rz7mong/mochi-rzmong/README.md

# 🍡 Mochi rzmong




Desk buddy **ESP32-C3 Super Mini** + LCD **ST7789 1.3" 240×240** (modul GMT130, PCB 27.78×39.22 mm, 7 pin tanpa CS): wajah **GIF**, reaksi sentuh, **SFX WAV**. Proyek open-source independen — **terinspirasi** Dasai Mochi, **bukan** produk resmi / clone berlisensi.

**Firmware: 0.5.6** · **MIT © rzmong** · English: [README.en.md](README.en.md)

Satu sumber situs/installer: **https://rz7mong.github.io/mochi-rzmong/**  
(`rz7mong.github.io` tanpa path adalah arsip — jangan flash dari sana.)

Di perangkat: **GIF + WAV 16-bit saja** (tidak ada pemutar MP4, tidak ada decoder MP3).

## 🚀 Mulai cepat

1. Chrome / Edge → [Instalasi firmware 0.5.6](https://rz7mong.github.io/mochi-rzmong/) (tahan BOOT, colok USB-C).
2. Wi-Fi AP default: **`rzmong mochi` / `rzmong123`** — sandi lab; **ganti** `MOCHI_AP_PASS` di firmware lalu flash ulang sebelum dipakai di tempat umum.
3. Pengaturan (disarankan): **`http://192.168.4.1/`** di AP perangkat.
4. Pack tema: [mochi-themes.zip](https://github.com/rz7mong/mochi-rzmong/releases/download/assets-v1/mochi-themes.zip) (Release [`assets-v1`](https://github.com/rz7mong/mochi-rzmong/releases/tag/assets-v1)) → ekstrak ke root SD FAT32 (`gif/` + `sfx/`). Tanpa SD pun, 30 GIF+WAV bawaan di flash langsung jalan.

## 🕐 Jam HP

LCD ini bukan layar sentuh. Jam HP dipilih dari HP.

1. Sambungkan Wi-Fi `rzmong mochi`, sandi `rzmong123`.
2. Buka `http://192.168.4.1/`.
3. Centang **Chronos BLE** dan **Jam HP**, lalu simpan.
4. Di aplikasi Chronos, sambungkan perangkat bernama `rzmong`.

Layar menampilkan GIF wajah default (senyum + kedip; `wajah/default.gif` di SD, atau versi bawaan di flash) dengan tanggal, jam, dan baterai HP di atasnya. Hilangkan centang Jam HP untuk kembali ke GIF. Notifikasi, panggilan, dan navigasi tetap menutup jam sementara.

Ketukan menu hanya dipakai jika ada kawat sentuh di GPIO1. Tanpa kawat itu, abaikan ketukan.

## 🔗 Tautan

| | |
| --- | --- |
| ⚡ Instalasi | https://rz7mong.github.io/mochi-rzmong/ |
| 🔧 Merakit + pin | [docs/hardware.html](https://rz7mong.github.io/mochi-rzmong/hardware.html) |
| 🧩 Demo rakit interaktif | [kabel lepas](https://rz7mong.github.io/mochi-rzmong/pemasangan-kabel.html) · [PCB carrier](https://rz7mong.github.io/mochi-rzmong/pemasangan.html) |
| 📖 Panduan pakai | [docs/panduan.html](https://rz7mong.github.io/mochi-rzmong/panduan.html) |
| 🎨 Studio (convert) | [docs/studio.html](https://rz7mong.github.io/mochi-rzmong/studio.html) |
| ⚙️ Pengaturan online | [docs/pengaturan.html](https://rz7mong.github.io/mochi-rzmong/pengaturan.html) |
| 🤝 Handoff | [HANDOFF.md](HANDOFF.md) · [halaman](https://rz7mong.github.io/mochi-rzmong/handoff.html) |
| 🧊 Case STL | [case/](case/) |
| 🟩 PCB carrier (opsional) | [pcb/](pcb/README.md) |
| 📌 Konstanta | [PRODUCT.md](PRODUCT.md) |

## 🔌 Wiring firmware 0.5.6

Sumber pin: `firmware/include/MochiRzmong.h` + `User_Setup_ST7789.h`.

Diagram resmi: [docs/wiring-0.5.1.jpg](docs/wiring-0.5.1.jpg) · halaman [hardware](https://rz7mong.github.io/mochi-rzmong/hardware.html).

```
ESP32-C3 Super Mini
  Touch OUT → GPIO1
  SD  SCK=4  MOSI=6  MISO=3  CS=5     (SPI berbagi SCK/MOSI dengan TFT)
  TFT SCLK=4 MOSI=6  CS=7*   DC=10  RST=0   BLK→3V3 (bukan 5V)
  I2S BCLK=21  LRC=20  DIN=8          (MAX98357; speaker ke OUT+/OUT− amp)
  GPIO2 dan GPIO9 — jangan disolder (strapping C3)
```

\* LCD GMT130 7 pin (GND VCC SCL SDA RES DC BLK) **tidak punya kaki CS** — GPIO7 dibiarkan kosong (CS di firmware tetap GPIO7, tidak mengganggu). Kabel disolder langsung ke pad LCD (tanpa pin header) karena tatakan baru hanya menyisakan ±2 mm di belakang baris pin.

**Pemasangan LCD:** di [tatakan GMT130](case/README.md) LCD dipasang **pin di bawah**. Mulai firmware 0.5.4 rotasi default = **2** (180°) supaya gambar tegak. Kalau masih pakai tatakan lama / pin di atas: menu LCD → **Rotasi layar** 2× (atau build dengan `-DMOCHI_DEFAULT_ROTATION=0`).

| Net | Apa yang disambung |
| --- | --- |
| GABUNG 3V3 | TFT VCC + BLK, SD VCC, TTP223 VCC |
| GABUNG GND | semua modul |
| GABUNG SCK GPIO4 | TFT SCL + SD SCK |
| GABUNG MOSI GPIO6 | TFT SDA + SD MOSI |
| GABUNG VIN | ESP VIN + MAX98357 VIN **setelah saklar** |

CS tidak berbagi: TFT **GPIO7** ≠ SD **GPIO5** ≠ sentuh **GPIO1** ≠ DIN **GPIO8**.

**Bukan “boot-safe”.** GPIO8 (DIN) adalah pin strapping C3. GPIO20/21 adalah UART0 — log boot bisa bocor ke I2S (“plok” di speaker). Pakai **USB CDC**, jangan andalkan UART0.

**Daya:** LiPo → TP4056 **berproteksi** (DW01/8205A) → saklar → GABUNG VIN. LCD/SD/sentuh makan **3V3 ESP**, bukan 5V.

**Amp:** pasang kapasitor **≈470 µF** (elektrolit, ≥10 V) antara **VIN MAX98357 dan GND**, sedekat mungkin ke modul. Tanpa ini amp mudah “ceklek” / brown-out saat bass.

**SD:** modul harus **native 3.3V** (bukan reader 5V / level-shifter 5V). Kartu FAT32. MISO = GPIO3, bukan GPIO2.

**Varian PCB carrier (opsional):** semua modul di atas bisa dipasang di [PCB etsa tangan 38.5 × 36 mm](pcb/README.md) (satu sisi, THT) dengan case/tatakan `_pcb`. Pin sama dengan tabel di atas. Part khusus varian ini: speaker **15 × 11 × 3.5 mm**, kapasitor **470 µF 10 V Ø6.3 × 11** tegak, modul **micro SD 3.3 V kecil ±18.5 × 20 mm**, LiPo **501640**. Rakitan kabel lepas tetap didukung.

Blueprint + STL: [hardware.html](https://rz7mong.github.io/mochi-rzmong/hardware.html).

## 🛠️ Troubleshooting singkat

| Gejala | Cek |
| --- | --- |
| Port tidak muncul di Chrome | Pakai **Chrome/Edge** (bukan Safari / in-app). Tahan **BOOT**, colok USB-C, lepas BOOT. Coba kabel data lain. |
| Wi-Fi tidak ketemu | Flash **0.5.6**. SSID **`rzmong mochi`**, bukan `Mochi-rzmong`. |
| Sandi ditolak | Default **`rzmong123`**, bukan `rzmong24`. |
| Layar putih/hitam | RST=**0**, DC=10, SCLK=4, MOSI=6, BLK=3V3 (CS=7 hanya jika modul punya kaki CS) |
| Gambar terbalik | Firmware 0.5.6 default rotasi 2 untuk LCD pin di bawah. Menu LCD → **Rotasi layar** 2× untuk membalik 180°. |
| SD gagal | FAT32, modul **3.3V native**, MISO=**3**, CS=5 — bukan GPIO2 |
| Amp berisik / mati saat bass | Kapasitor ≈470 µF di VIN amp |
| Bunyi plok saat boot | UART0 di 20/21 + strapping GPIO8. Jangan tarik DIN ke GND. |
| Upload dari Pages gagal | Mixed content. Upload lewat `http://192.168.4.1/` |

## 🎞️ GIF + WAV bawaan (0.5.6)

Tanpa kartu SD, firmware memutar **30 slot GIF+WAV di flash** (1,04 MB di partisi app; WAV 8 kHz 16-bit mono):

- **wajah/default** — wajah putih senyum + kedip (dari video), dipakai juga untuk Jam HP dan diselang di antara klip lain.
- **Wajah/musik warna (reaksi sentuh)**: raspberry (tickle), squint (kedip), love_hearts_kiss (cinta), angry_2 (marah), smirk (ketawa), sleepy (ngantuk), yawn_tired (nguap), rainbow (pelangi), pong (pong).
- **Mobil (14)**: revs (ngebut), headlights, accel, gtr_rain, road_rage, rotation, speed_2, speed_3, tsurikawa, turbo, car, lb, lb_intro, lb_star.
- **Gundam (6)**: hadouken_miss, hadouken_hit (reaksi hadouken), blade, mecha_doc, titan, equip. Gundam besar (kokpit, pilot, helm…) hanya dari SD.

File SD dengan tema+stem sama tetap didahulukan (reaksi sentuh selalu cek SD dulu). Daftar & urutan: `firmware/assets/meta.json`, file: `firmware/assets/builtin/`.

## 🎬 Media

Studio butuh internet (FFmpeg.wasm). Setelah file jadi, sambung AP Mochi lalu unggah di captive (same-origin).

Pasangan: `/gif/<tema>/<stem>.gif` + `/sfx/<tema>/<stem>.wav`

## 🏗️ Build

```bash
cd firmware
python tools/embed_assets.py
pio run -e esp32-c3-super-mini
```

## 📄 Lisensi

**MIT © rzmong** — lihat [LICENSE](LICENSE) dan [THIRD_PARTY_NOTICES.md](THIRD_PARTY_NOTICES.md) (ChronosESP32 / fbiego).
