rz7mong/mochi-rzmong/case/stickers_yaemiko/README.md

# MOCHI rzmong · Sakura Kitsune: lembar stiker terinspirasi Yae Miko (`case_luar_lcd_23_40mm.stl`)

Set decal bertema kuil rubah untuk case [`case_luar_lcd_23_40mm.stl`](../case_luar_lcd_23_40mm.stl) (63.9 × 93.5 × 53.4 mm). Motifnya semua orisinal: siluet kitsune (topeng dan rubah duduk berekor tiga), bunga dan kelopak sakura, jimat ofuda, omamori, tali shimenawa dengan kertas shide, lonceng suzu, gerbang torii, dan petir untuk aksen Electro.

Palet warna: pink sakura `#F2A7C3`, putih, merah kuil `#C8202F`, ungu Electro `#8E4FD6`, emas `#D4A64A`, navy gelap `#1C1E3D`.

> Desain buatan penggemar yang **terinspirasi karakter Yae Miko. Bukan produk resmi.** Tidak ada art resmi, logo, nama game, maupun merek dagang Genshin Impact / HoYoverse di dalamnya. Kanji yang dipakai hanya kata umum (桜 sakura, 狐 rubah, 雷 petir, 御守 jimat, 白狐, 桜花, 雷光, 餅), dan teks latinnya cuma "MOCHI rzmong", "SAKURA KITSUNE", dan "KITSUNE". Lencana petir dalam belah ketupat juga bentuk orisinal, bukan ikon elemen dari game.

Ukuran, posisi, dan penomoran potongan sama dengan lembar LBWK ([`../stickers/`](../stickers/)) dan lembar gaya Gundam ([`../stickers_gundam/`](../stickers_gundam/)).

## File

| File | Isinya |
|---|---|
| `sticker_sheet_A4_white_vinyl.pdf` / `.svg` | **File cetak utama.** A4, skala 1:1, gambar + garis potong magenta `#FF00FF` 0.1 mm (layer tersendiri di SVG) |
| `sticker_sheet_A4_white_vinyl_PRINT_ONLY_no_cutlines.pdf` | Halaman yang sama tanpa garis potong, untuk mesin print-and-cut (Cricut / Silhouette / Brother) |
| `sticker_sheet_A4_CUT_ONLY.svg` / `.pdf` | Hanya jalur potong, posisinya pas dengan halaman A4 yang sama |
| `sticker_sheet_A4_clear_vinyl.pdf` / `.svg` | Versi vinyl bening (bagian putih dihilangkan). Pakai hanya di case putih atau yang dicat putih |
| `sticker_sheet_A4_white_vinyl_preview.png` | Pratinjau lembar utama 200 dpi |
| `placement_guide.png` | Enam tampilan dengan posisi bernomor dan keterangan tiap stiker |
| `mockup_stickers_applied.png`, `mockup_closeups.png` | Render case dengan stiker terpasang |

## Cetak

- Cetak di **100 % / "Actual size"**, jangan pernah "Fit to page". Pastikan batang 50 mm benar-benar 50 mm dan kotaknya 10 × 10 mm.
- **Bahan:** vinyl printable putih glossy + laminasi bening glossy, atau kertas decal waterslide putih yang ditutup clear coat.
- Printer rumahan tidak bisa mencetak warna putih. Di lembar putih, tulisan MOCHI, topeng rubah, bunga putih, dan kertas shide berupa vinyl polos; di vinyl bening bagian itu jadi transparan. Pink, ungu, dan emas di vinyl bening juga agak tembus pandang.
- **Warna emas dicetak sebagai oker datar**, bukan metalik. Kalau mau emas mengilap sungguhan, perlu foil atau printer tinta metalik.
- Potongan solid punya bleed 0.5 mm; decal yang berdiri sendiri punya margin putih 0.3 mm.
- Semua teks sudah di-outline. Teks terkecil (tinggi huruf kapital sekitar 0.75–1.0 mm: teks melingkar di emblem, "KITSUNE", baris kecil di sayap dan skirt) butuh printer **≥1200 dpi** dalam mode best/photo. Tanda utama (MOCHI 4.4 mm, segel 狐, blok 雷, kanji ofuda) tetap tajam.
- Sekitar 75 mm bagian bawah lembar sengaja dikosongkan. Potong dan pakai lagi vinylnya.

## Pemasangan

- **Depan** = sisi layar. **L** = sisi kiri mobil (+X), **R** = sisi kanan mobil (−X), dilihat dari belakang. Pasangan cermin (3, 4, 5, 6, 8) ada versi R/L; rubah, petir, dan bunga di ujung jejak kelopak selalu menghadap ke depan.
- Urutan yang disarankan: IPA → depan (18, 19, 20) → skirt 6R/6L, lalu 1–5 di tiap sisi → belakang (10, 11, 9, 13, 12) → sayap (7, 8R/8L) → ventilasi 14 → semprotan sakura 15 → strip kubah 16a–d (atau 17) → tambahan 21 sesuai selera → clear coat tipis opsional (coba dulu di stiker cadangan).
- Coba pas-kan potongan besar (7, 18, 3, 13) dengan kertas alasnya masih terpasang sebelum dikelupas.
- Strip kubah 16a–d dipotong per segmen karena kubahnya melengkung. Tempel di garis tengah, ujung ketemu ujung, mulai dari tengah ke arah luar; sedikit panas hair dryer membantu. Kalau berkerut, pakai strip tunggal ALT (17B pink, 17C ungu). Untuk waterslide, pakai decal softener di bagian kubah.
- **Potongan yang rumit:** kertas shide di 2/13, garis rubah dan torii (21c, 21f), dan margin kelopak kecil 21a punya bagian yang tipis. Potong pelan-pelan dengan **pisau yang tajam/baru**, atau sederhanakan jalur potongnya di SVG kalau mesin potongnya kesulitan.

## Persiapan permukaan

- **Resin:** cuci sampai bersih dan lakukan **post-cure penuh** (resin yang masih lengket membuat stiker tidak menempel), amplas tipis bekas support atau beri primer/cat kalau mau, lalu **lap dengan IPA** tepat sebelum menempel.
- **FDM (PLA/PETG):** amplas tipis garis layer-nya atau beri primer, lalu lap dengan IPA.

Keterangan lengkap stiker beserta ukuran dan posisi pastinya: lihat `placement_guide.png`.
