rz7mong/mochi-rzmong/case/stickers/README.md

# Mochi rzmong: lembar stiker gaya LBWK

Livery buatan penggemar yang orisinal (putih / hitam / merah) untuk case Mochi. **Terinspirasi gaya LBWK (Liberty Walk) / F40. Bukan produk resmi.** Tidak ada logo resmi Liberty Walk, Ferrari, atau Dasai di dalamnya, dan semua nama sponsor (KUMO FUEL, PIXEL GRIP, RZMONG WORKS, DESK GT) hanya karangan.

Ukuran diukur pada case [`case_luar_lcd_23_40mm.stl`](../case_luar_lcd_23_40mm.stl) (63.9 × 93.5 × 53.4 mm).

## File

| File | Isinya |
|---|---|
| `sticker_sheet_A4_white_vinyl.pdf` / `.svg` | **File cetak utama.** A4, skala 1:1, gambar plus garis potong magenta 0.1 mm (layer SVG "CUT") |
| `sticker_sheet_A4_white_vinyl_PRINT_ONLY_no_cutlines.pdf` | Halaman yang sama tanpa garis potong, untuk mesin print-and-cut (Cricut / Silhouette / Brother) |
| `sticker_sheet_A4_CUT_ONLY.svg` / `.pdf` | Hanya jalur potong, posisinya pas dengan halaman A4 yang sama |
| `sticker_sheet_A4_clear_vinyl.pdf` / `.svg` | Versi vinyl bening. Bagian putih dihilangkan, jadi pakai hanya di case berwarna putih |
| `sticker_sheet_A4_white_vinyl_preview.png` | Pratinjau lembar stiker 200 dpi |
| `placement_guide.png` | Posisi penempelan bernomor dan keterangan tiap stiker |
| `mockup_stickers_applied.png`, `mockup_closeups.png` | Render case dengan stiker terpasang |

## Cetak

- Cetak di **100 % / "Actual size"**, jangan "Fit to page". Pastikan batang 50 mm benar-benar 50 mm dan kotaknya 10 × 10 mm.
- **Bahan:** vinyl printable putih glossy dengan laminasi bening glossy, atau kertas decal waterslide putih yang ditutup clear coat. Kalau pakai printer inkjet, gunakan vinyl khusus inkjet dan biarkan hasil cetak kering sekitar 1 jam sebelum dilaminasi.
- Printer rumahan tidak bisa mencetak warna putih. Di vinyl bening, area "putih" akan jadi transparan dan memperlihatkan warna case.

## Pemasangan

- **Depan** = sisi layar. **L** = sisi kiri mobil (+X), **R** = sisi kanan mobil (−X), dilihat dari belakang.
- Urutan yang disarankan: splitter dan grille (17, 18, 19), lalu skirt dan samping (5, 1–4), belakang (9, 10, 8, 12, 11), sayap (6, 7), ventilasi (13), dan strip kubah paling akhir (14/15 atau 16).
- Strip kubah dibagi menjadi beberapa segmen karena kubahnya melengkung ke dua arah. Tempel tiap segmen di garis tengah, mulai dari bagian tengahnya, lalu pertemukan ujung-ujungnya. Hangatkan vinyl dengan hair dryer dan tekan ke arah luar. Kalau stripnya berkerut, pakai strip ALT yang lebih tipis (16).
- Tekan penutup ventilasi (13) ke alur kisi-kisi dengan kuku.
- Kalau mau, akhiri dengan clear coat tipis. Coba dulu di stiker cadangan.

## Persiapan permukaan

- **FDM (PLA/PETG):** amplas tipis garis layer-nya, atau beri primer dan cat, lalu lap dengan IPA. Vinyl kurang menempel di garis layer yang kasar.
- **Resin:** cuci dan lakukan post-cure penuh terlebih dahulu, karena resin yang belum matang membuat lem tidak menempel. Setelah itu amplas tipis atau beri primer, lalu lap dengan IPA tepat sebelum menempel.

Keterangan lengkap stiker beserta ukuran dan posisi pastinya: lihat `placement_guide.png`.
