rz7mong/mochi-rzmong/case/stickers_gundam/README.md

# MOCHI rzmong RZ-78: lembar stiker gaya Gunpla/mecha (`case_luar_lcd_23_40mm.stl`)

Set decal untuk case [`case_luar_lcd_23_40mm.stl`](../case_luar_lcd_23_40mm.stl) (63.9 × 93.5 × 53.4 mm). Desain orisinal dengan skema warna ala RX-78: putih, biru `#1F4FA8`, merah `#D61F26`, kuning `#F5C400`, hampir hitam `#1A1A1C`.

> Terinspirasi decal model kit Gunpla / mecha. **Bukan produk resmi.** Tidak ada nama atau logo Gundam, Bandai, atau Sunrise di dalamnya. Semua kode (RZ-78, MOCHI-01, R.Z.M.F., "MOCHI CORPS", LOT 0026) hanya karangan.

## File
| file | isinya |
|---|---|
| `sticker_sheet_A4_white_vinyl.pdf` / `.svg` | File cetak **utama**: A4, skala 1:1, gambar + garis potong magenta `#FF00FF` 0.1 mm (layer tersendiri di SVG). |
| `sticker_sheet_A4_white_vinyl_PRINT_ONLY_no_cutlines.pdf` | Halaman yang sama tanpa garis potong, untuk mesin print-and-cut. |
| `sticker_sheet_A4_CUT_ONLY.svg` / `.pdf` | Hanya jalur potong, posisinya pas dengan halaman A4 yang sama. |
| `sticker_sheet_A4_clear_vinyl.pdf` / `.svg` | Versi vinyl bening (bagian putih dihilangkan). Hanya untuk case putih atau yang dicat putih. |
| `sticker_sheet_A4_white_vinyl_preview.png` | Pratinjau lembar utama 200 dpi. |
| `placement_guide.png` | Enam tampilan dengan posisi bernomor dan keterangan tiap stiker. |
| `mockup_stickers_applied.png`, `mockup_closeups.png` | Render case dengan decal terpasang. |

## Cetak
* Cetak di **100 % / "Actual size"**, jangan pernah "Fit to page". Cek batang 50 mm dan kotak 10 × 10 mm.
* **Bahan:** vinyl printable putih glossy + laminasi bening glossy, atau kertas decal waterslide putih yang ditutup clear coat (paling mirip decal "model kit").
* Printer rumahan tidak bisa mencetak warna putih: teks putih akan berupa vinyl polos (lembar putih) atau tembus pandang (lembar bening).
* Potongan solid punya bleed 0.5 mm; decal yang berdiri sendiri punya margin putih 0.3 mm.
* Semua teks sudah di-outline. Teks mikro terkecil (tinggi huruf kapital 0.72–0.95 mm) butuh printer **≥1200 dpi** dalam mode best/photo; teks ini hanya hiasan. Tanda utama (1.9–4.6 mm) tetap terbaca.
* Sekitar 90 mm bagian bawah lembar sengaja dikosongkan — potong dan pakai lagi.

## Tips pemasangan
* **Persiapan cetakan resin:** cuci sampai bersih dan lakukan **post-cure penuh** (resin yang masih lengket membuat stiker tidak menempel), amplas tipis bekas support, beri primer/cat kalau mau, lalu **lap dengan IPA** sebelum menempel.
* Coba pas-kan potongan besar (7, 18, 3) dengan kertas alasnya masih terpasang sebelum dikelupas.
* Potongan kubah yang melengkung (14, 15, 16a–d) — tempel dari tengah ke arah luar; sedikit panas akan membantu. Gunakan decal softener untuk waterslide. Kalau tri-stripe 5.5 mm berkerut, pakai strip tunggal ALT (17B/17C).
* Urutan yang disarankan: IPA → depan (18, 19, 20) → samping (6, 1–5) → belakang (10, 11, 9, 13, 12) → sayap (7, 8) → ventilasi 14 → V-fin 15 → strip kubah 16/17 → tambahan 21 → clear coat tipis opsional (coba dulu).
* Depan = sisi layar; pasangan cermin (3–6, 8) R/L; chevron dan segitiga selalu menghadap ke depan. Lihat `placement_guide.png` untuk posisi pastinya.
