rz7mong/mochi-rzmong/PRODUCT.md

# Product constants (single source of truth)

| Key | Value |
| --- | --- |
| **Version** | `0.5.6` |
| **Brand** | `rzmong` |
| **AP SSID** | `rzmong mochi` |
| **AP password** | `rzmong123` (change in firmware; not exposed in API JSON) |
| **On-device settings** | `http://192.168.4.1/` (captive UI — recommended) |
| **Studio** | Convert online, then upload via captive form on AP |
| **GIF size limit** | max **~600000** bytes upload buffer |
| **Chronos BLE name** | `rzmong` |
| **Jam HP** | phone time over wajah/default.gif (SD, else built-in smile+blink face), phone battery % |
| **Built-ins** | 30 GIF+WAV slots in flash (`firmware/assets/builtin/`, list in `firmware/assets/meta.json`), WAV 8 kHz 16-bit mono; 11 tap reactions |
| **Theme pack** | Release `assets-v1` → [mochi-themes.zip](https://github.com/rz7mong/mochi-rzmong/releases/download/assets-v1/mochi-themes.zip) (86 GIF + 87 WAV) |
| **Media** | GIF 240×240 + WAV 16-bit mono ~22 kHz |
| **Hardware** | ESP32-C3 Super Mini + ST7789 1.3" 240×240 GMT130 (PCB 27.78×39.22 mm, 7-pin, no CS) |
| **LCD mount** | `case/tatakan_GMT130_fit.stl`, pins-down → default rotation `2` (`MOCHI_DEFAULT_ROTATION`) |

```c
#define MOCHI_VERSION "0.5.6"
#define MOCHI_AP_NAME "rzmong mochi"
#define MOCHI_AP_PASS "rzmong123"
```

**Erase on install:** wipes NVS (theme, volume, Chronos). SD is separate.

**GIF+SFX pair:** `/gif/<tema>/<stem>.gif` + `/sfx/<tema>/<stem>.wav`

**Touch (device):** notif 1-tap · call hold 0.6s · nav 2-tap hide · play 1-tap react / 2-tap menu
