rz7mong/mochi-rzmong/docs/HANDOFF.md

# Handoff — Mochi rzmong v0.5.6

Salinan web: [handoff.html](handoff.html) · sumber repo: [../HANDOFF.md](https://github.com/rz7mong/mochi-rzmong/blob/main/HANDOFF.md)

| Key | Value |
| --- | --- |
| Version | **0.5.6** |
| AP | `rzmong mochi` / `rzmong123` (lab; ganti di firmware) |
| Settings | `http://192.168.4.1/` |
| Settings (Pages) | [pengaturan.html](pengaturan.html) |
| Install | https://rz7mong.github.io/mochi-rzmong/ |
| Theme pack | [assets-v1](https://github.com/rz7mong/mochi-rzmong/releases/tag/assets-v1) · [mochi-themes.zip](https://github.com/rz7mong/mochi-rzmong/releases/download/assets-v1/mochi-themes.zip) (86 GIF + 87 WAV) |
| Built-ins | 30 GIF+WAV di flash (`firmware/assets/builtin/`, `meta.json`); wajah/default baru (senyum + kedip) |
| Hardware | ESP32-C3 Super Mini + ST7789 1.3" 240×240 GMT130 (27.78×39.22 mm, 7 pin tanpa CS, pin di bawah) |
| Media | GIF + WAV 16-bit (bukan MP4/MP3) |
| License | MIT © rzmong |

Jam HP: dipilih dari HP di http://192.168.4.1/ (centang Chronos BLE dan Jam HP). LCD tidak sentuh. GPIO1 hanya jika ada kawat sentuh.
