rz7mong/mochi-rzmong/case/stickers_yaemiko/mockup_closeups.png

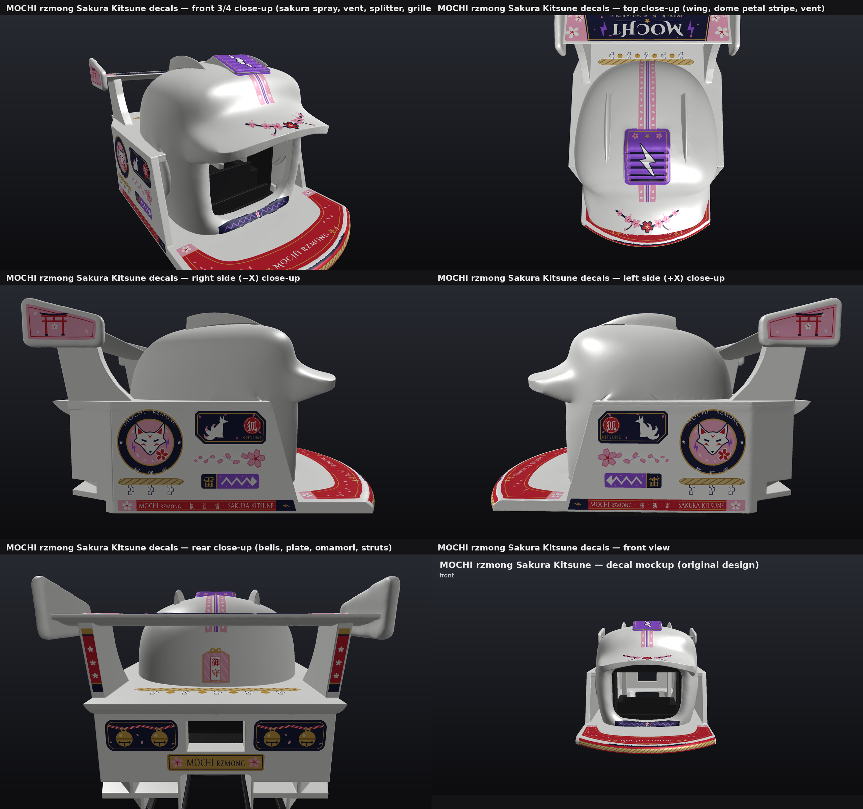
case/stickers_yaemiko/mockup_closeups.png
