rz7mong/mochi-rzmong/case/stickers_yaemiko/mockup_stickers_applied.png

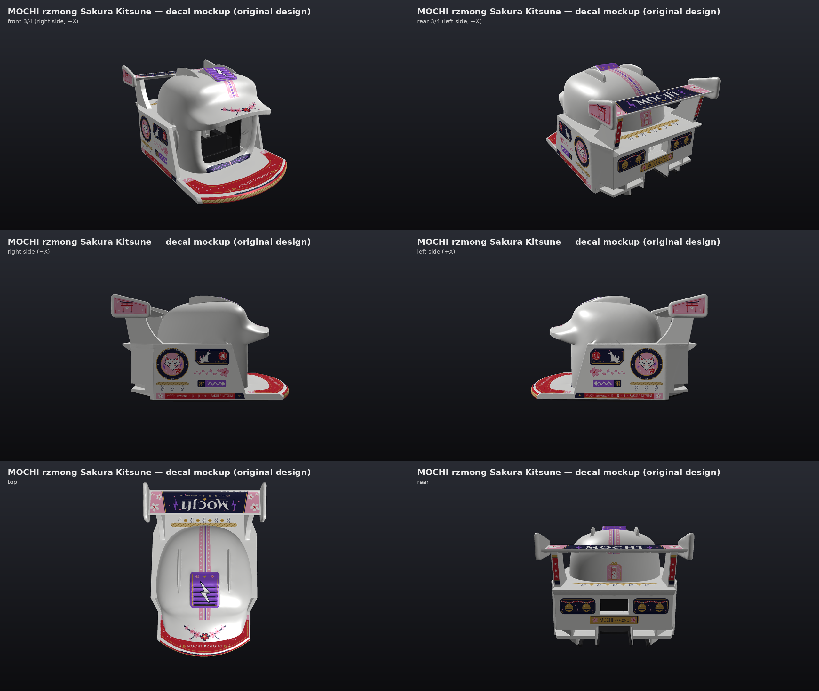
case/stickers_yaemiko/mockup_stickers_applied.png
