rz7mong/mochi-rzmong/case/stickers_yaemiko/sticker_sheet_A4_white_vinyl_preview.png

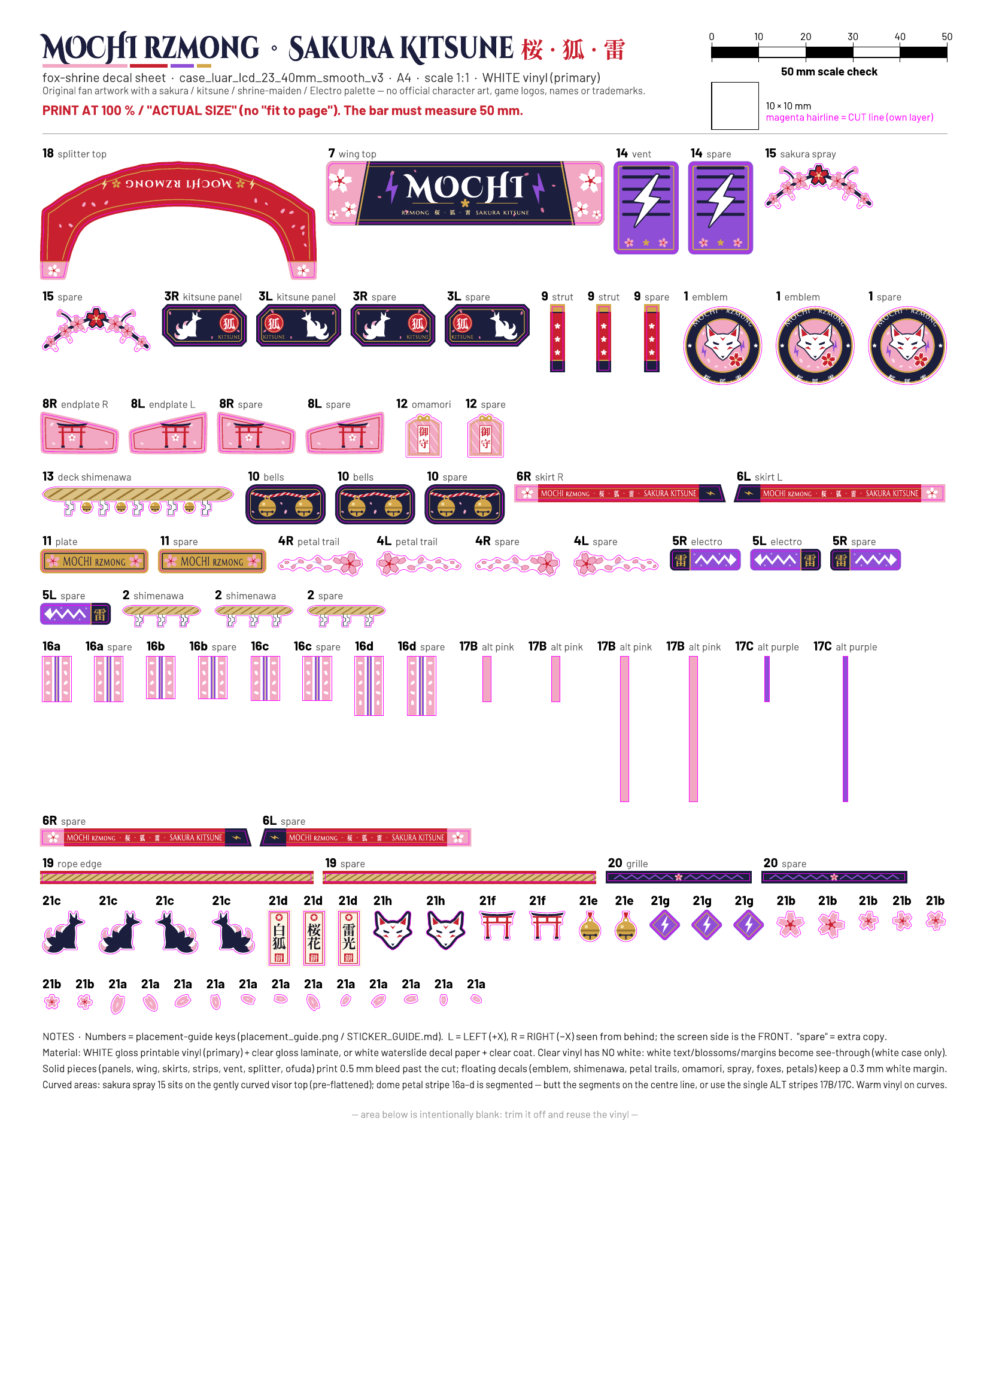
case/stickers_yaemiko/sticker_sheet_A4_white_vinyl_preview.png
