rz7mong/mochi-rzmong/docs/fit/pcb_headroom_map_v2.png

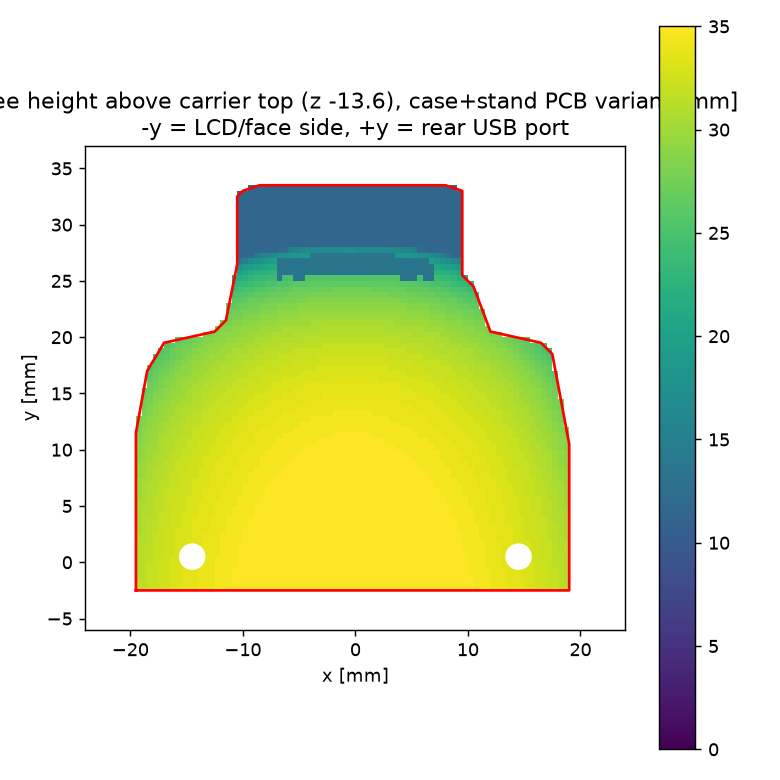
docs/fit/pcb_headroom_map_v2.png
