rz7mong/mochi-rzmong/docs/fit/pcb_layout_v2_top.png

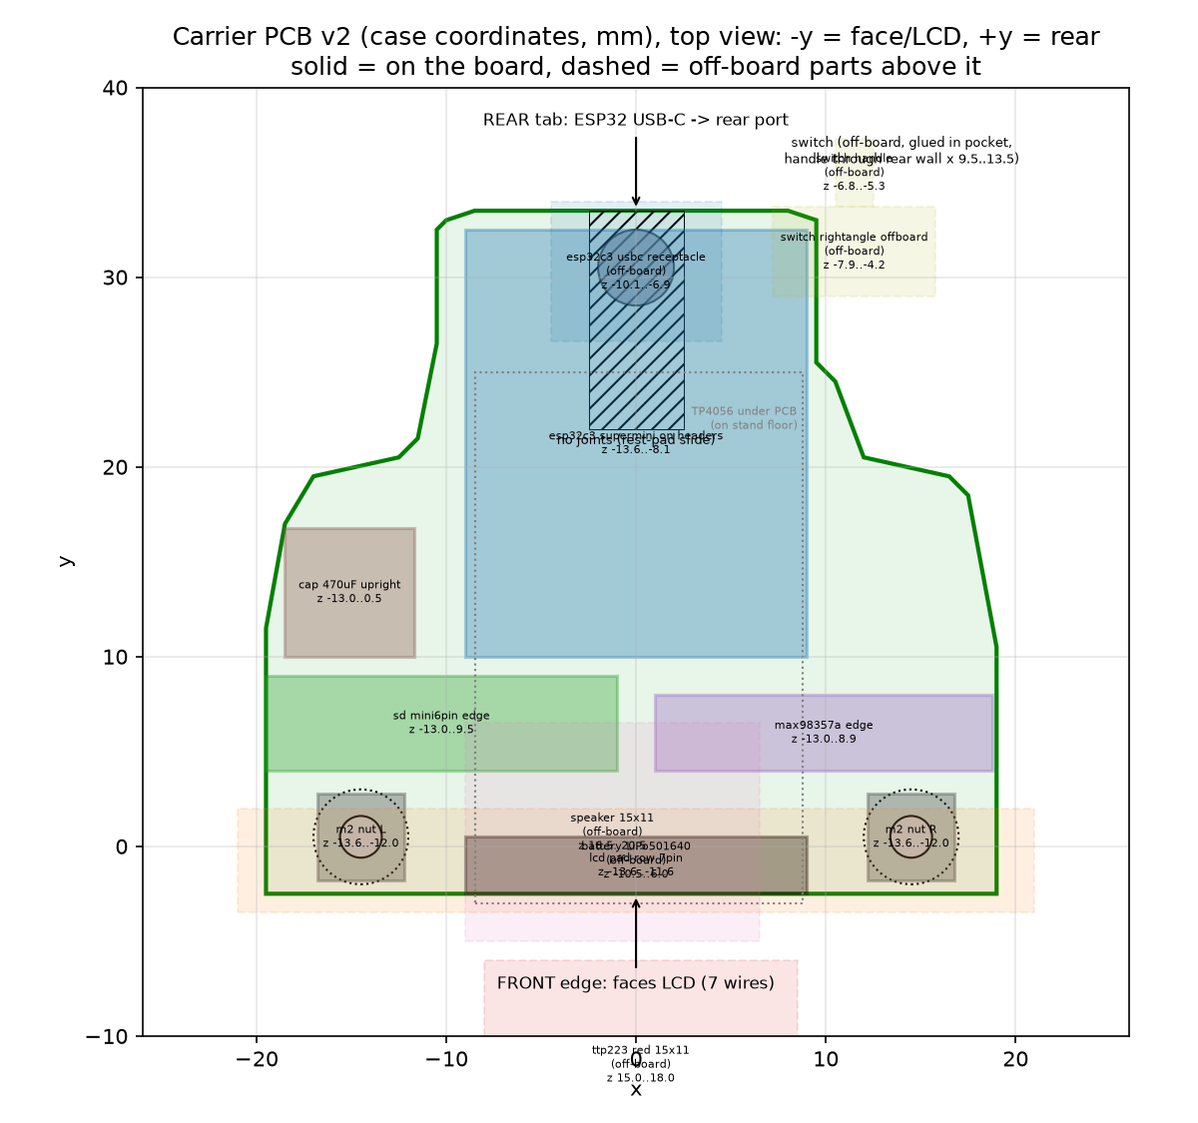
docs/fit/pcb_layout_v2_top.png
