rz7mong/mochi-rzmong/docs/fit/sections_pcb_v7.png

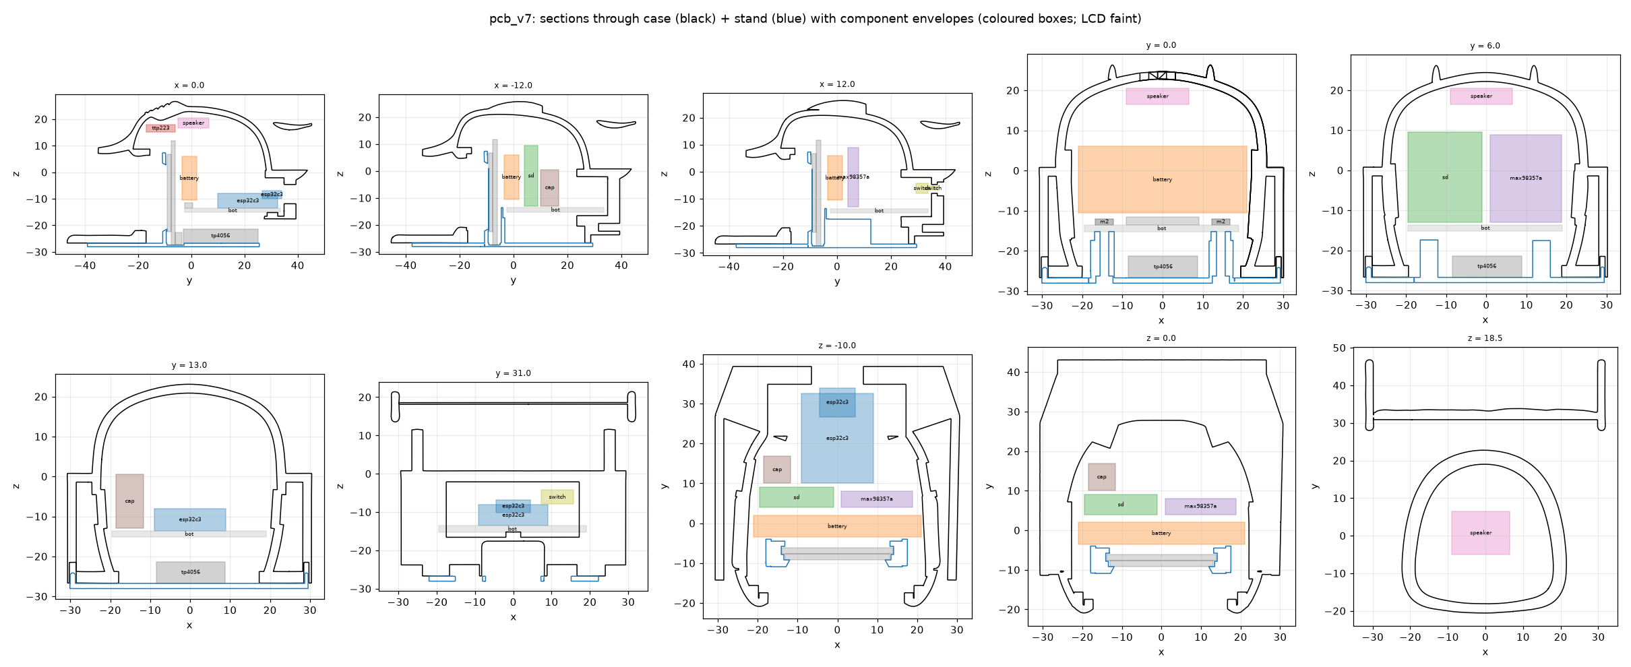
docs/fit/sections_pcb_v7.png
