rz7mong/mochi-rzmong/docs/jam-hp.gif

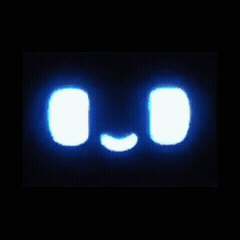
docs/jam-hp.gif
