rz7mong/mochi-rzmong/pcb/v3/copper_preview.png

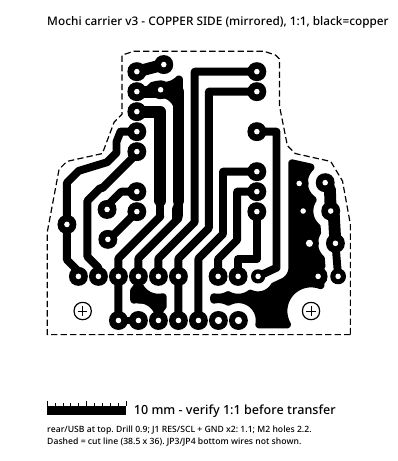
pcb/v3/copper_preview.png
