rz7mong/mochi-rzmong/pcb/v3/preview_component_side.png

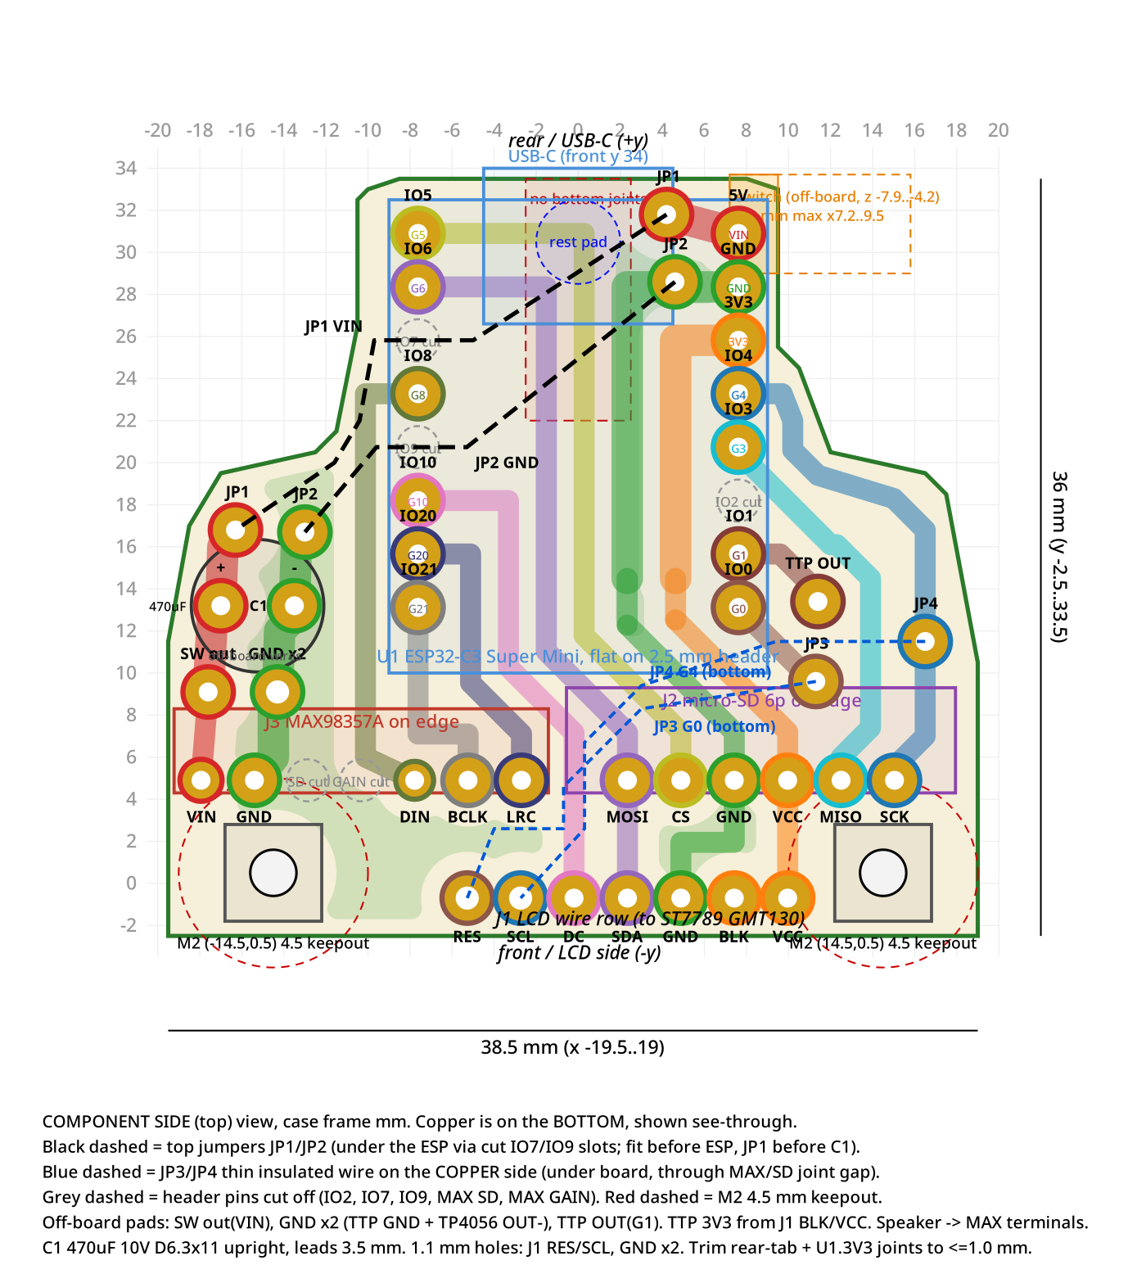
pcb/v3/preview_component_side.png
