rz7mong/mochi-rzmong/case/case_luar_lcd_23_40mm.stl

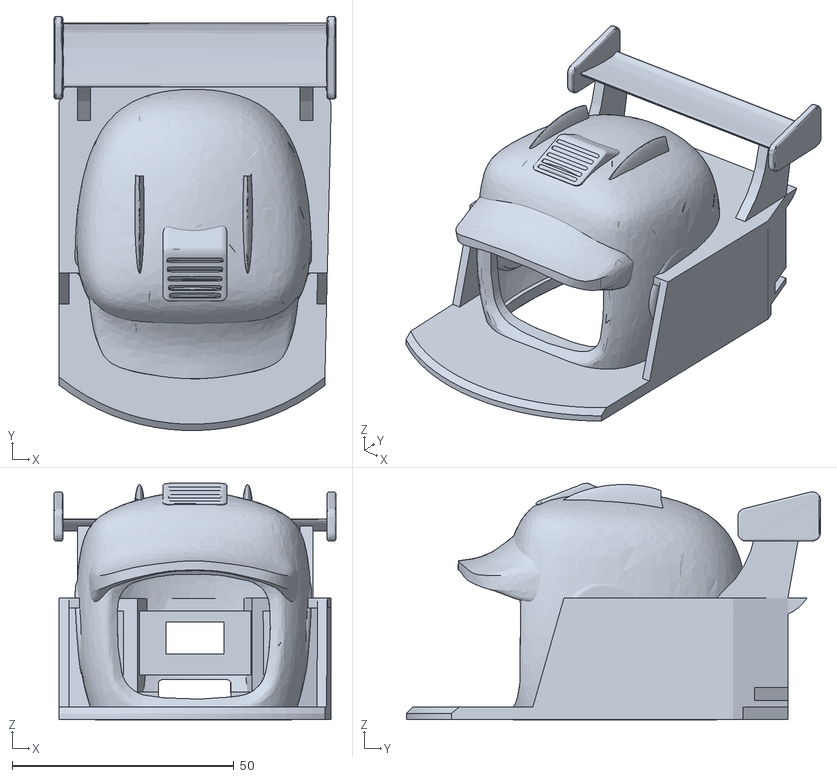
[picture p13: CAD file, 2026-09-30]
case/case_luar_lcd_23_40mm.stl
63.6 x 93.4 x 53.4
