rz7mong/mochi-rzmong/pcb/outline/pcb_recommended_outline_v2.dxf

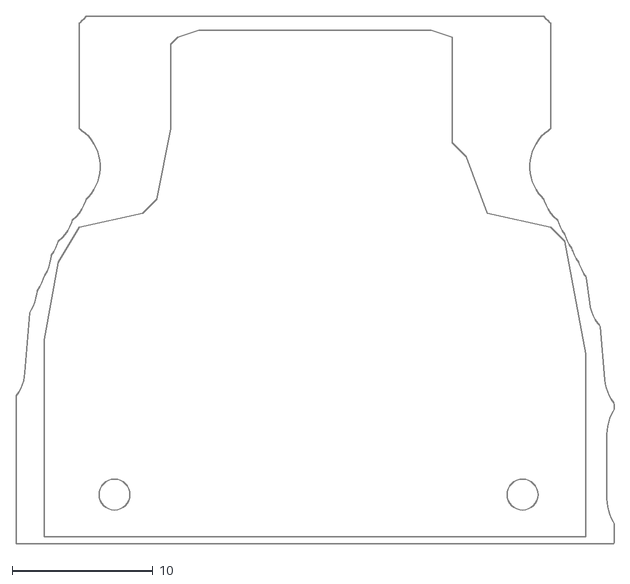
[picture p14: CAD file, 2026-10-01]
pcb/outline/pcb_recommended_outline_v2.dxf
42.5 x 37.5
