rz7mong/mochi-rzmong/case/tatakan_lcd_23_40mm.stl

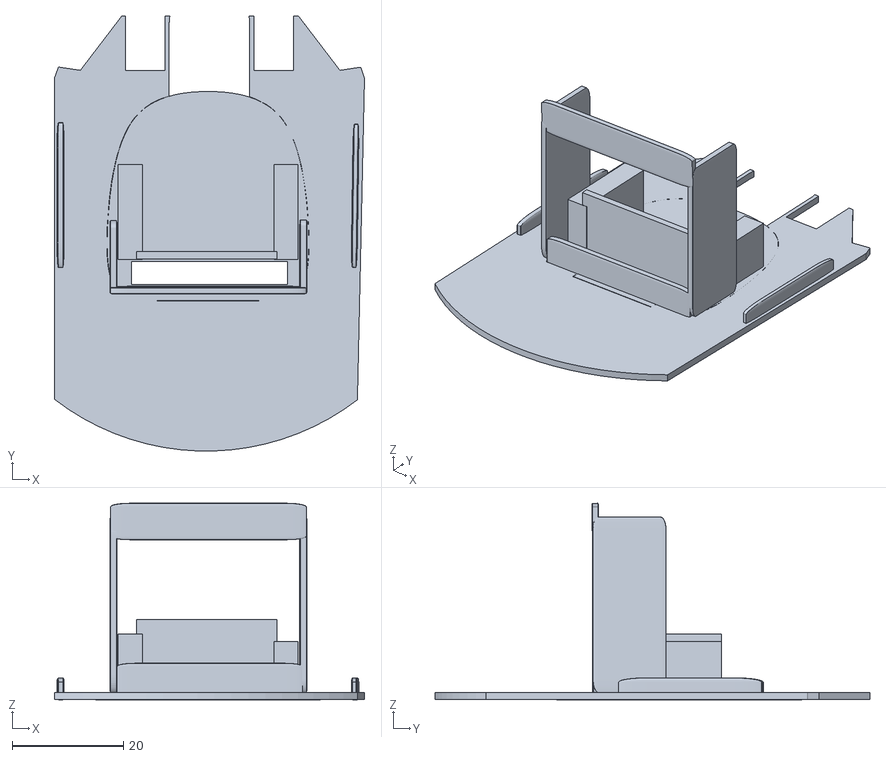
[picture p15: CAD file, 2026-09-30]
case/tatakan_lcd_23_40mm.stl
55.8 x 78.2 x 35.4
