rz7mong/mochi-rzmong/sd-pack/UPLOAD_INSTRUCTIONS.md

# Upload selesai

Pack penuh sudah di Release:

- Tag: **assets-v1**
- URL: https://github.com/rz7mong/mochi-rzmong/releases/tag/assets-v1
- Download: https://github.com/rz7mong/mochi-rzmong/releases/download/assets-v1/mochi-themes.zip

Isi: 86 GIF + 87 WAV + themes.json (update 2026-10-02: versi warna 8 fps, wajah/default baru, love_hearts_kiss + yawn_tired)

Untuk SD card: extract zip ke root FAT32 (folder `gif/`, `sfx/`, file `themes.json`).
