rz7mong/mochi-rzmong/case/stickers_yaemiko/placement_guide.png

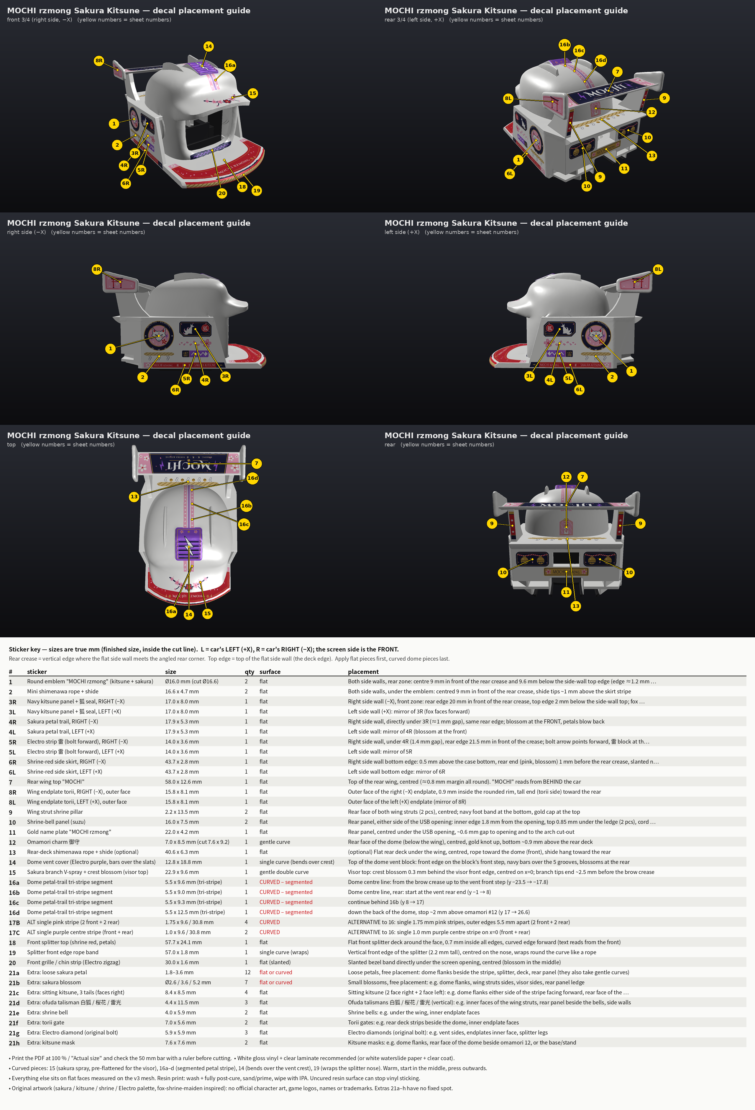
case/stickers_yaemiko/placement_guide.png
