rz7mong/mochi-rzmong/docs/fit/assembly3d_pcb_v7.png

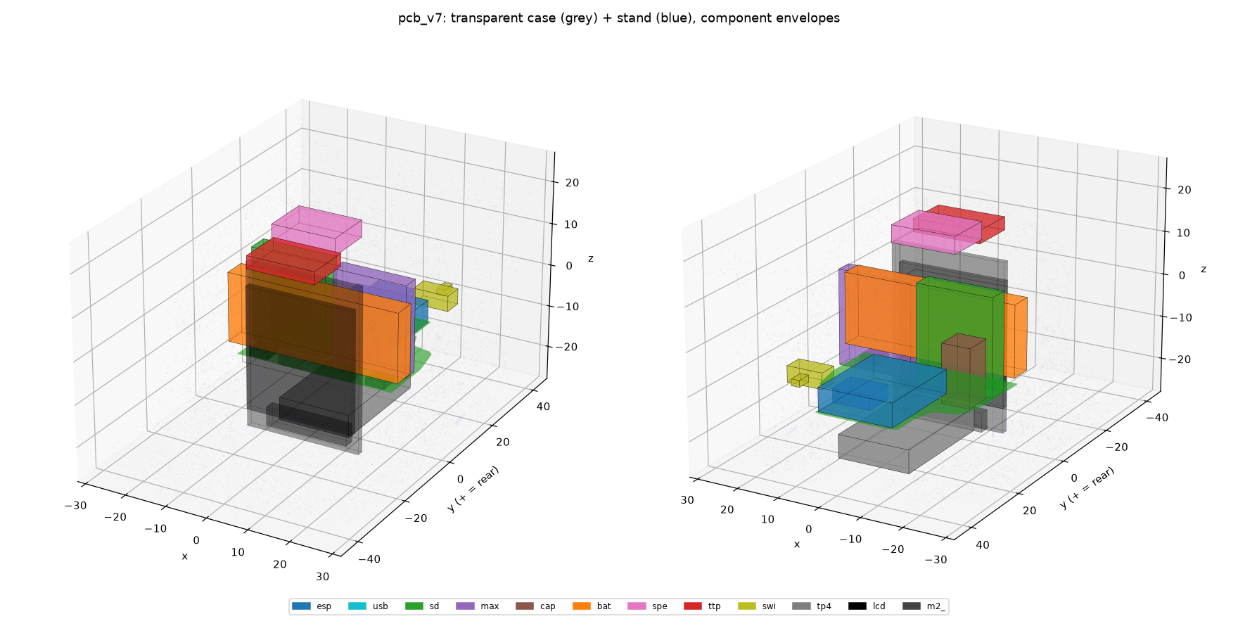
docs/fit/assembly3d_pcb_v7.png
