rz7mong/mochi-rzmong/docs/wiring-0.5.1.jpg

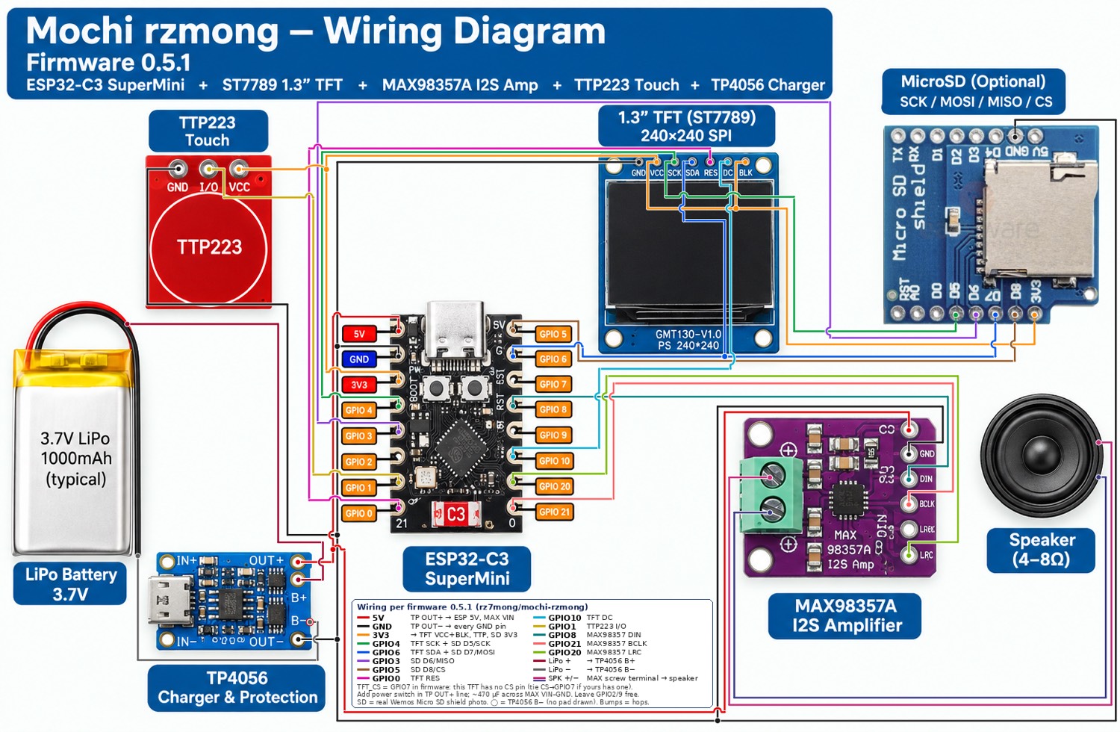
docs/wiring-0.5.1.jpg
