rz7mong/mochi-rzmong/pcb/v3/copper_mirrored_1to1.pdf

## Mochi carrier v3 - COPPER SIDE (mirrored), 1:1, black=copper

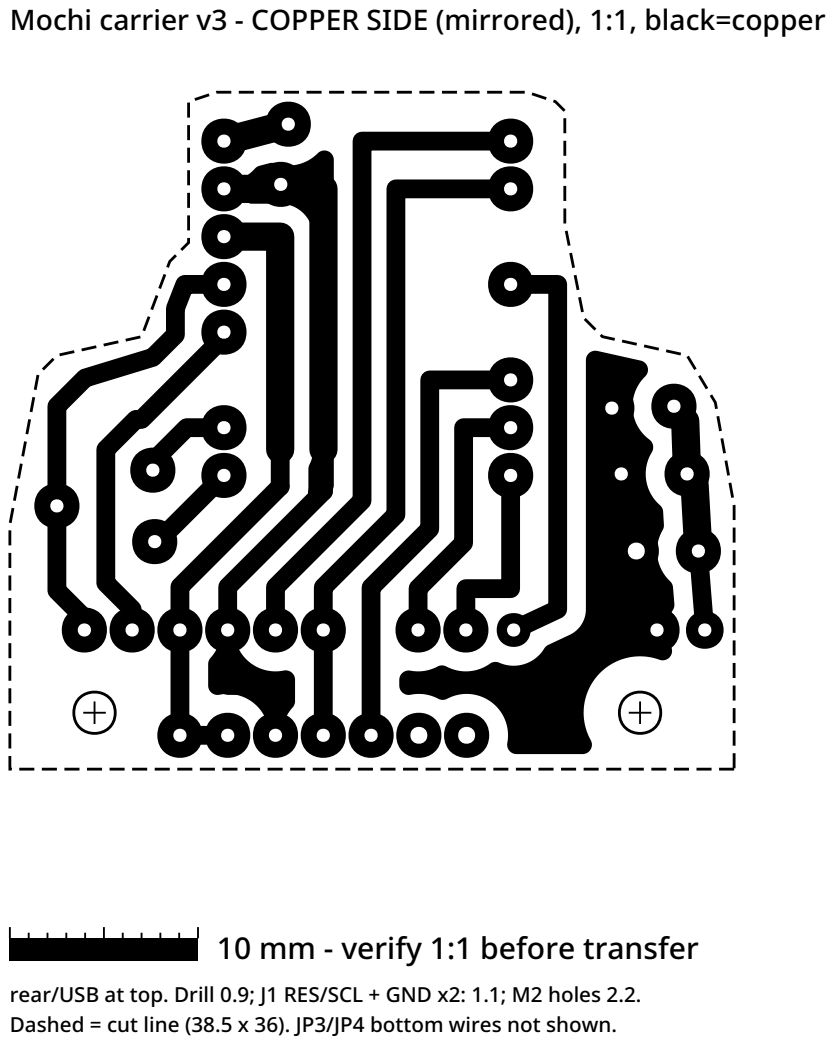
[picture p19: page 1]

10 mm - verify 1:1 before transfer

rear/USB at top. Drill 0.9; J1 RES/SCL + GND x2: 1.1; M2 holes 2.2.
Dashed = cut line (38.5 x 36). JP3/JP4 bottom wires not shown.
