rz7mong/mochi-rzmong/case/stickers_yaemiko/sticker_sheet_A4_white_vinyl_PRINT_ONLY_no_cutlines.pdf

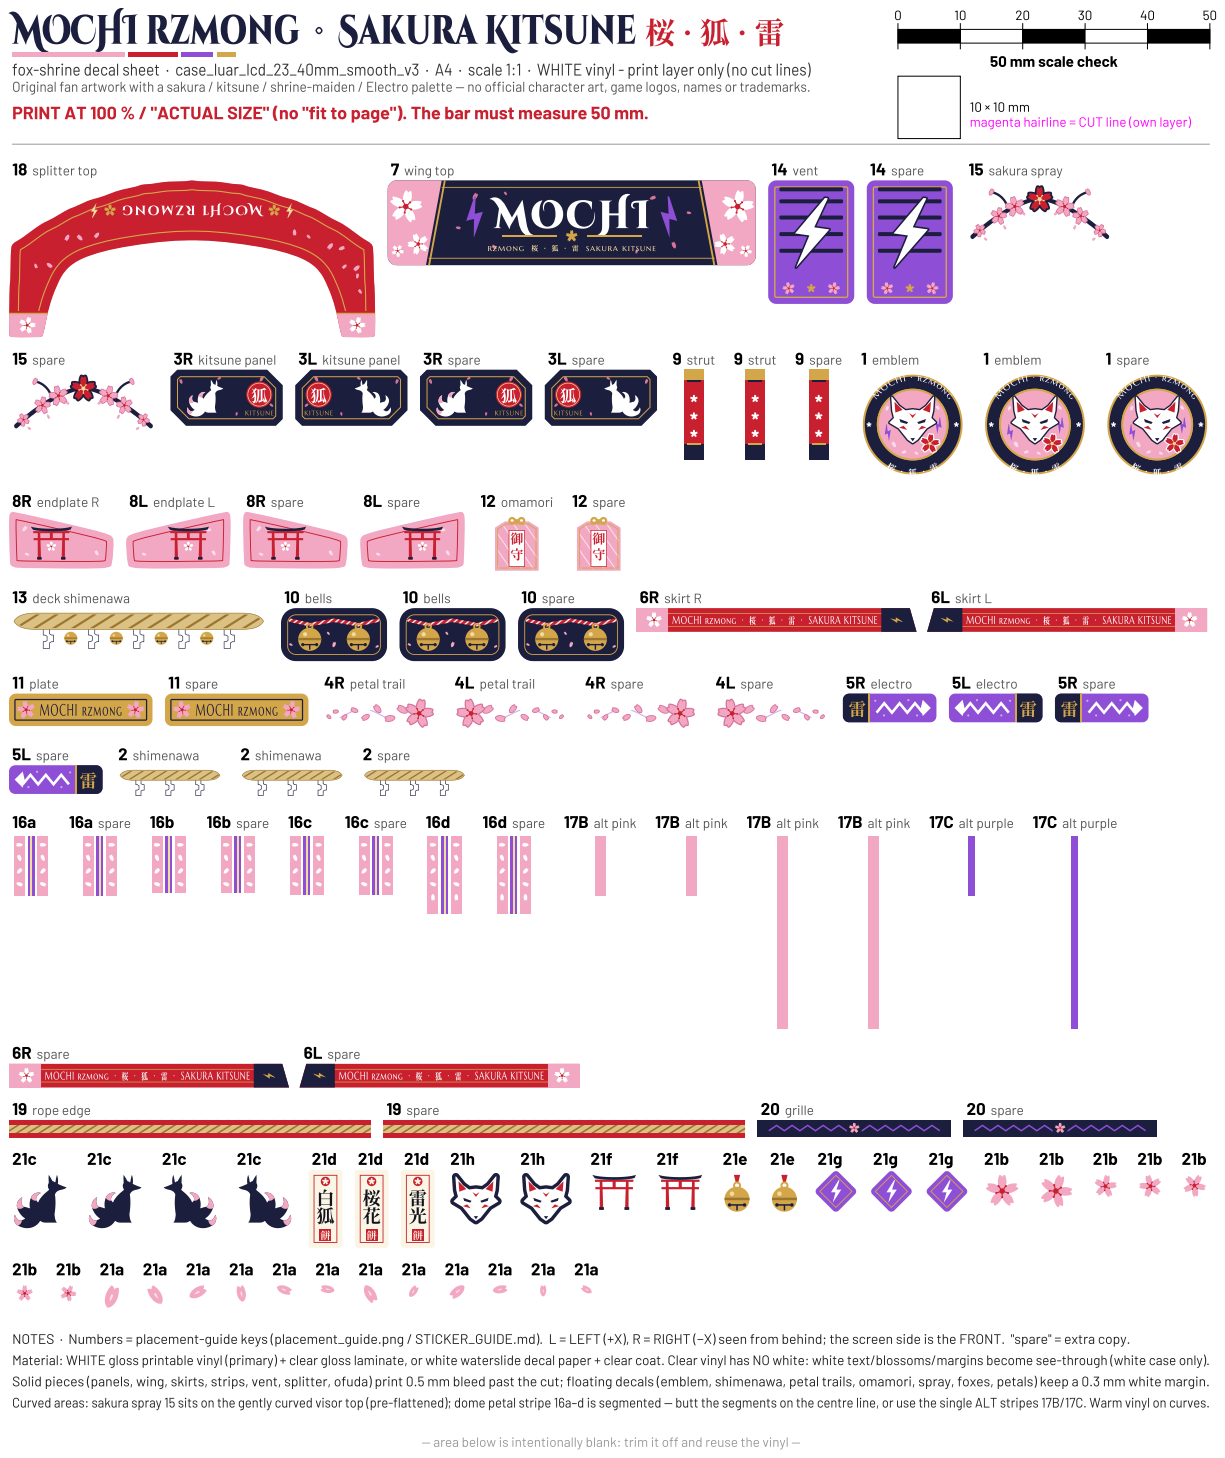
[picture p20: page 1]
