rz7mong/mochi-rzmong/case/stickers_yaemiko/sticker_sheet_A4_clear_vinyl.pdf

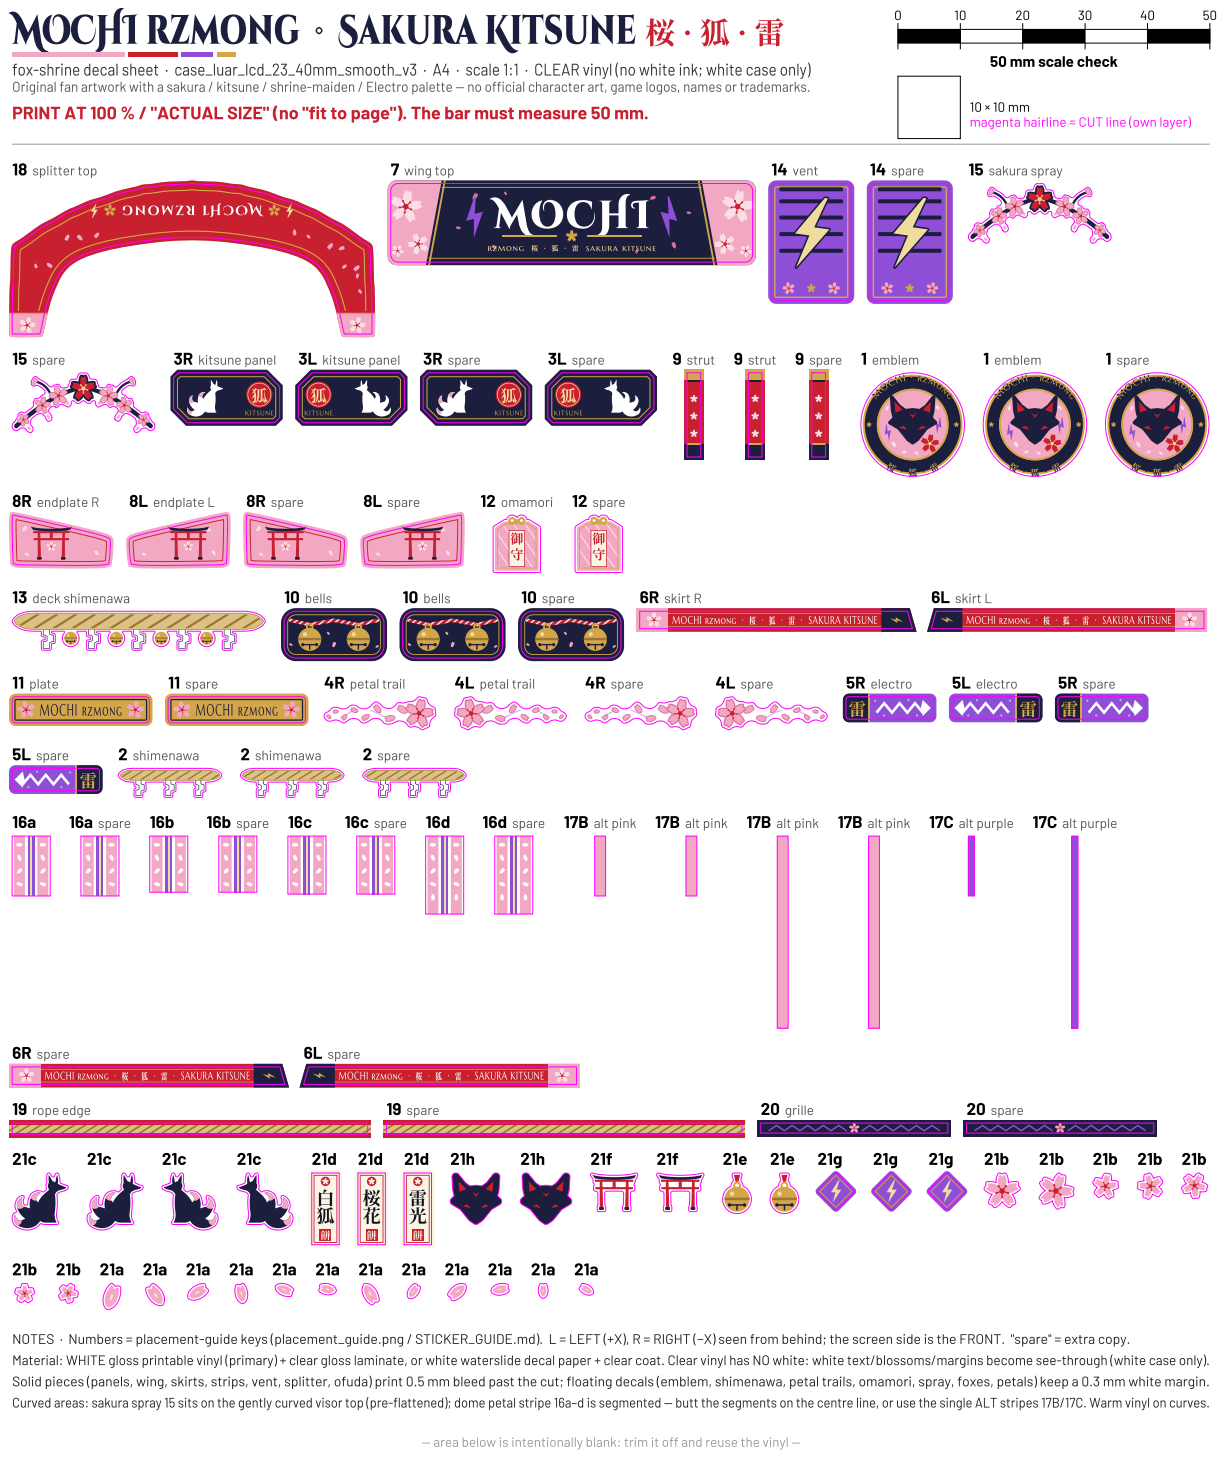
[picture p21: page 1]
