rz7mong/mochi-rzmong/case/stickers_yaemiko/sticker_sheet_A4_CUT_ONLY.pdf

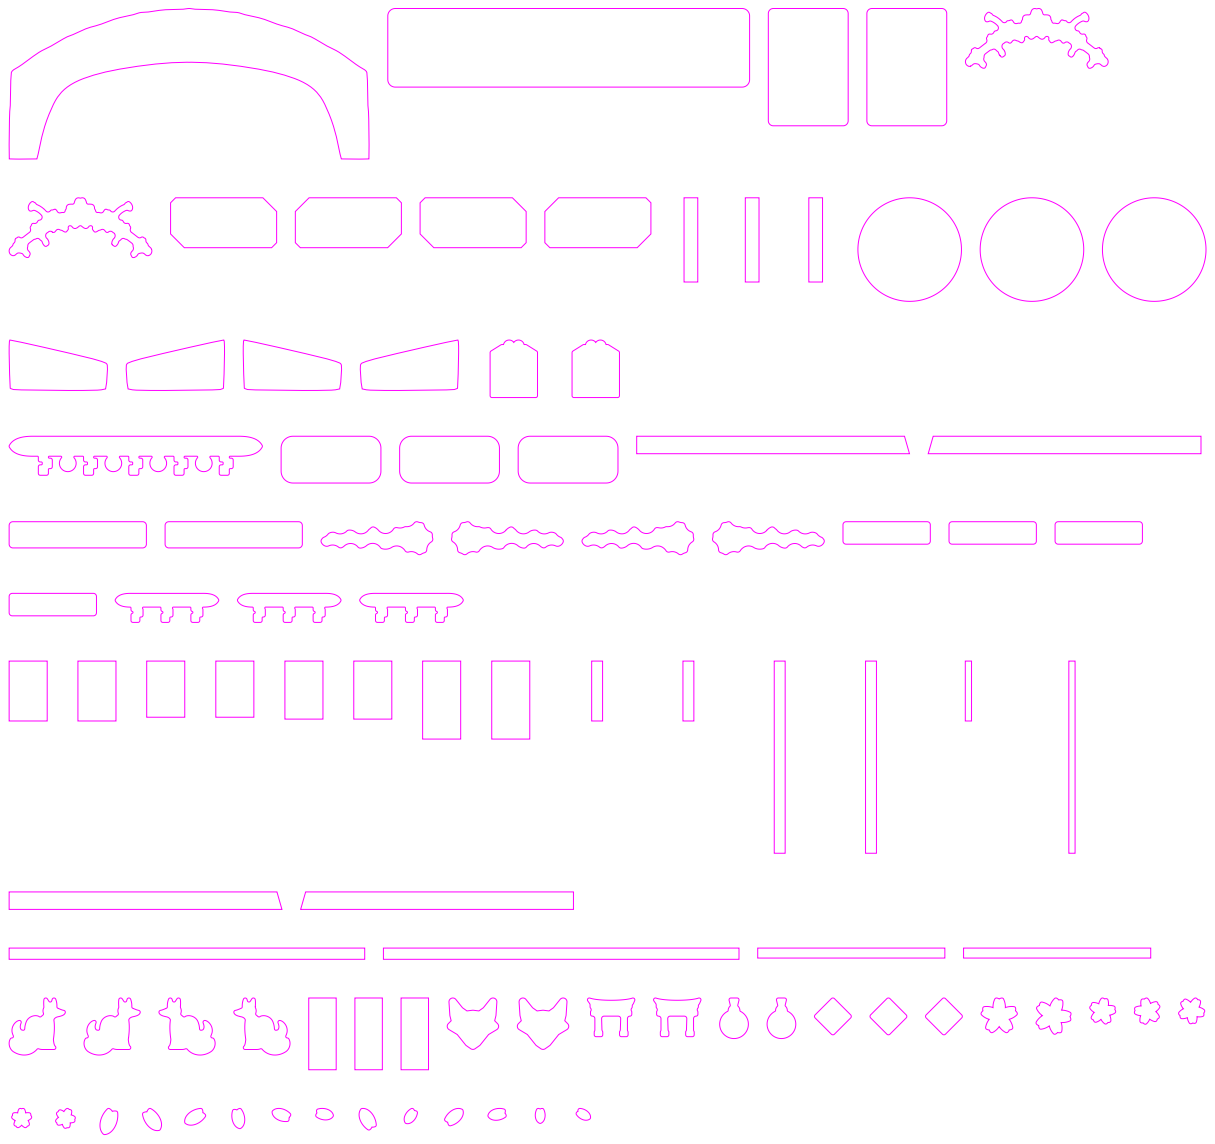
[picture p22: page 1]
