rz7mong/mochi-rzmong/case/stickers_yaemiko/sticker_sheet_A4_white_vinyl.pdf

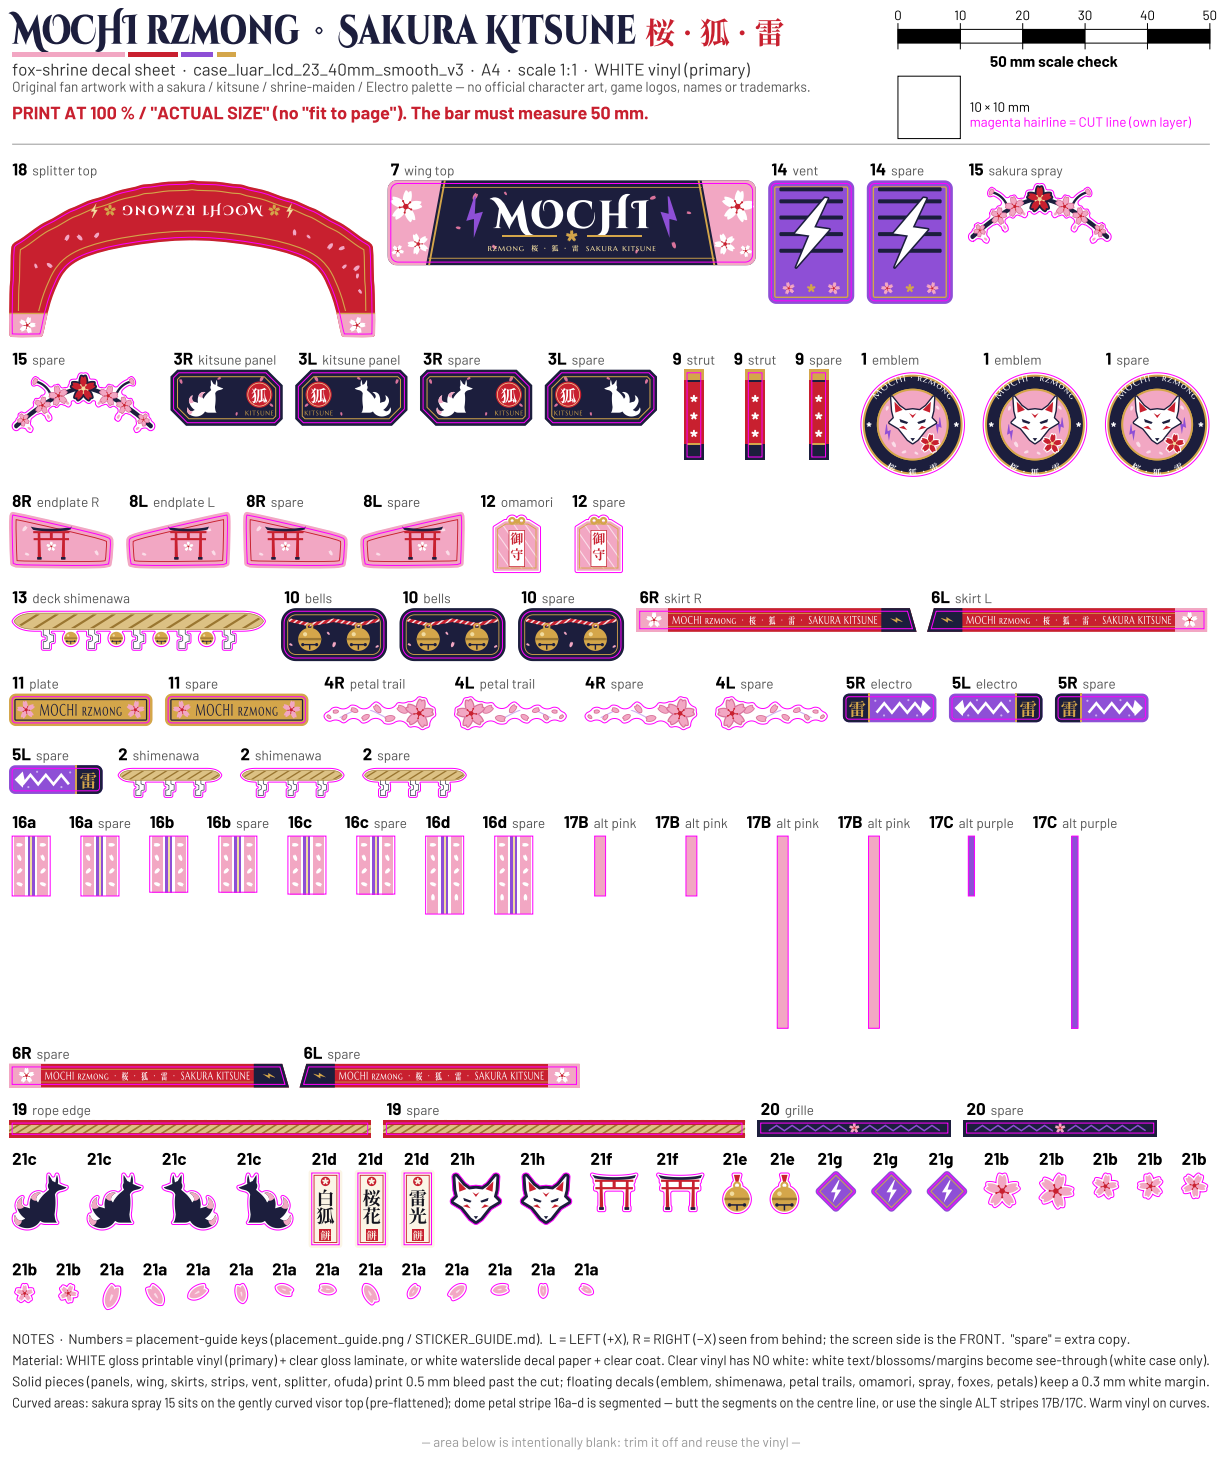
[picture p23: page 1]
