rz7mong/mochi-rzmong/case/stickers_gundam/sticker_sheet_A4_white_vinyl_PRINT_ONLY_no_cutlines.pdf

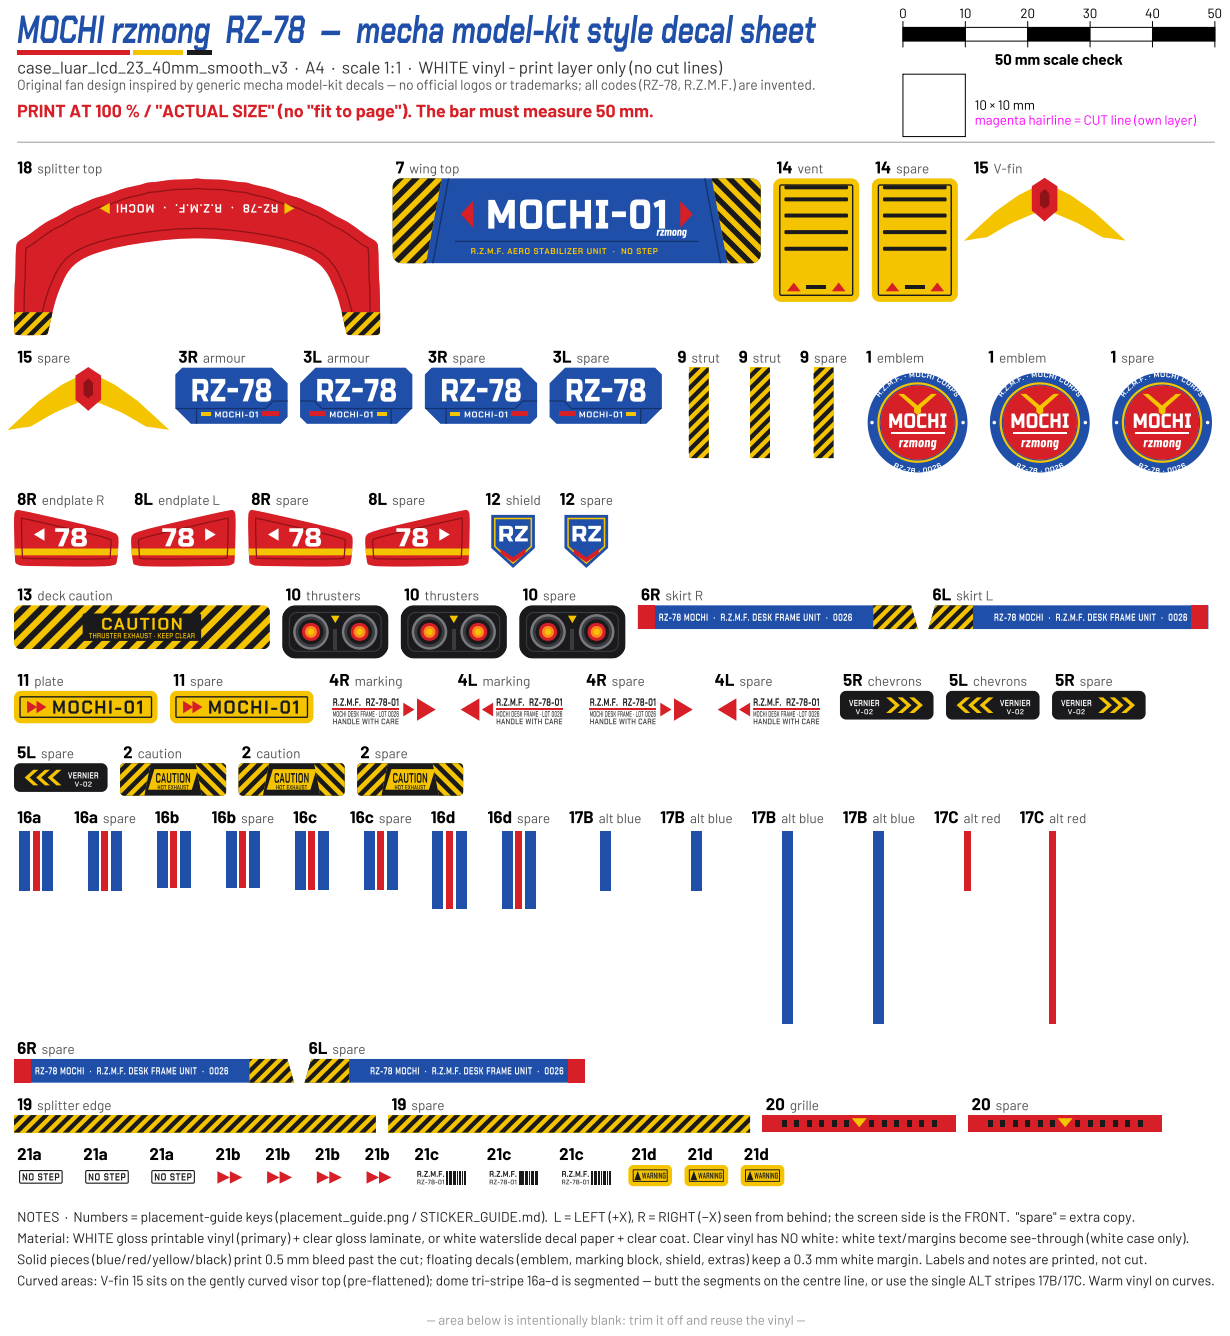
[picture p24: page 1]
