rz7mong/mochi-rzmong/case/stickers/sticker_sheet_A4_white_vinyl_PRINT_ONLY_no_cutlines.pdf

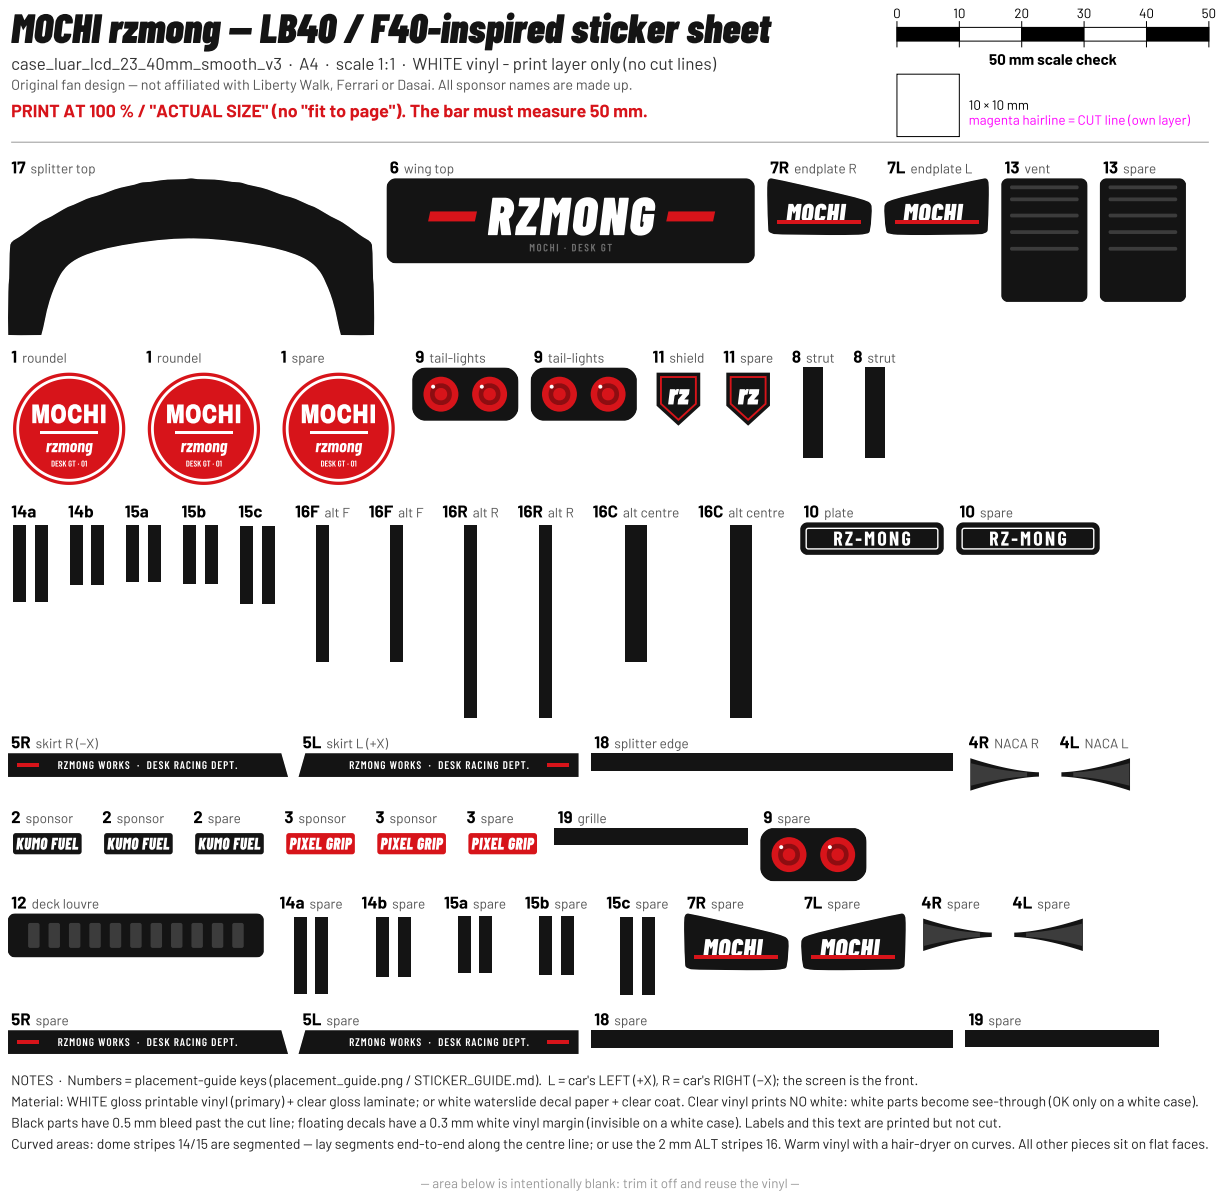
[picture p25: page 1]
