rz7mong/mochi-rzmong/case/stickers_gundam/sticker_sheet_A4_clear_vinyl.pdf

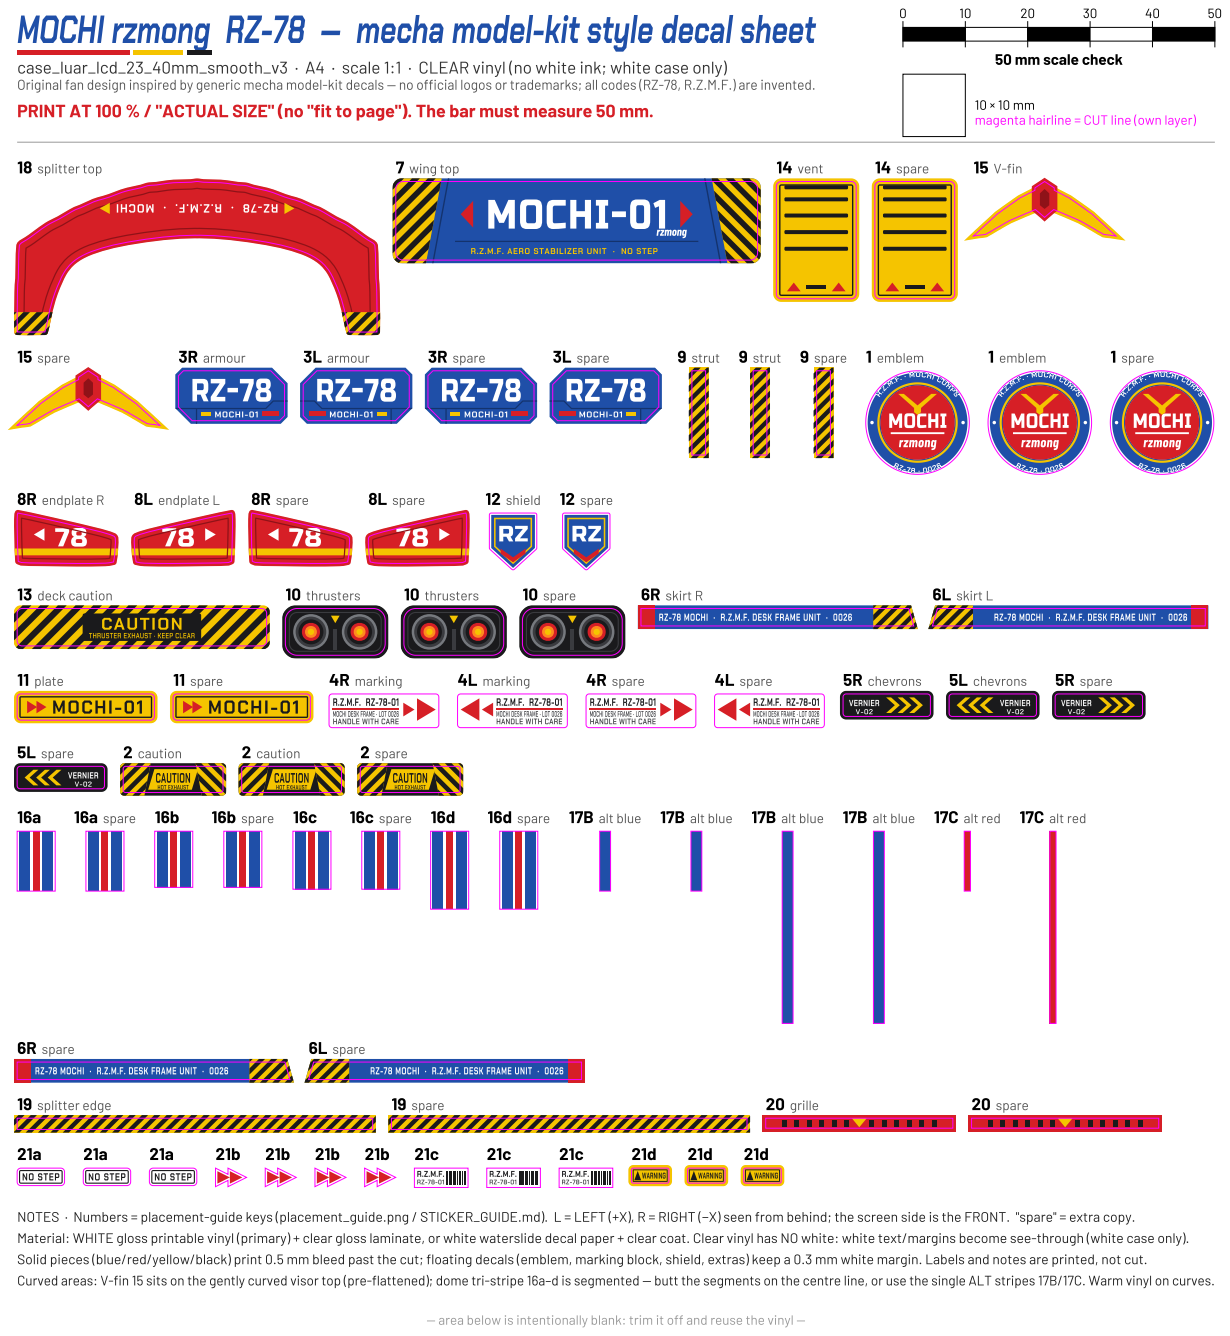
[picture p26: page 1]
