rz7mong/mochi-rzmong/case/stickers_gundam/sticker_sheet_A4_CUT_ONLY.pdf

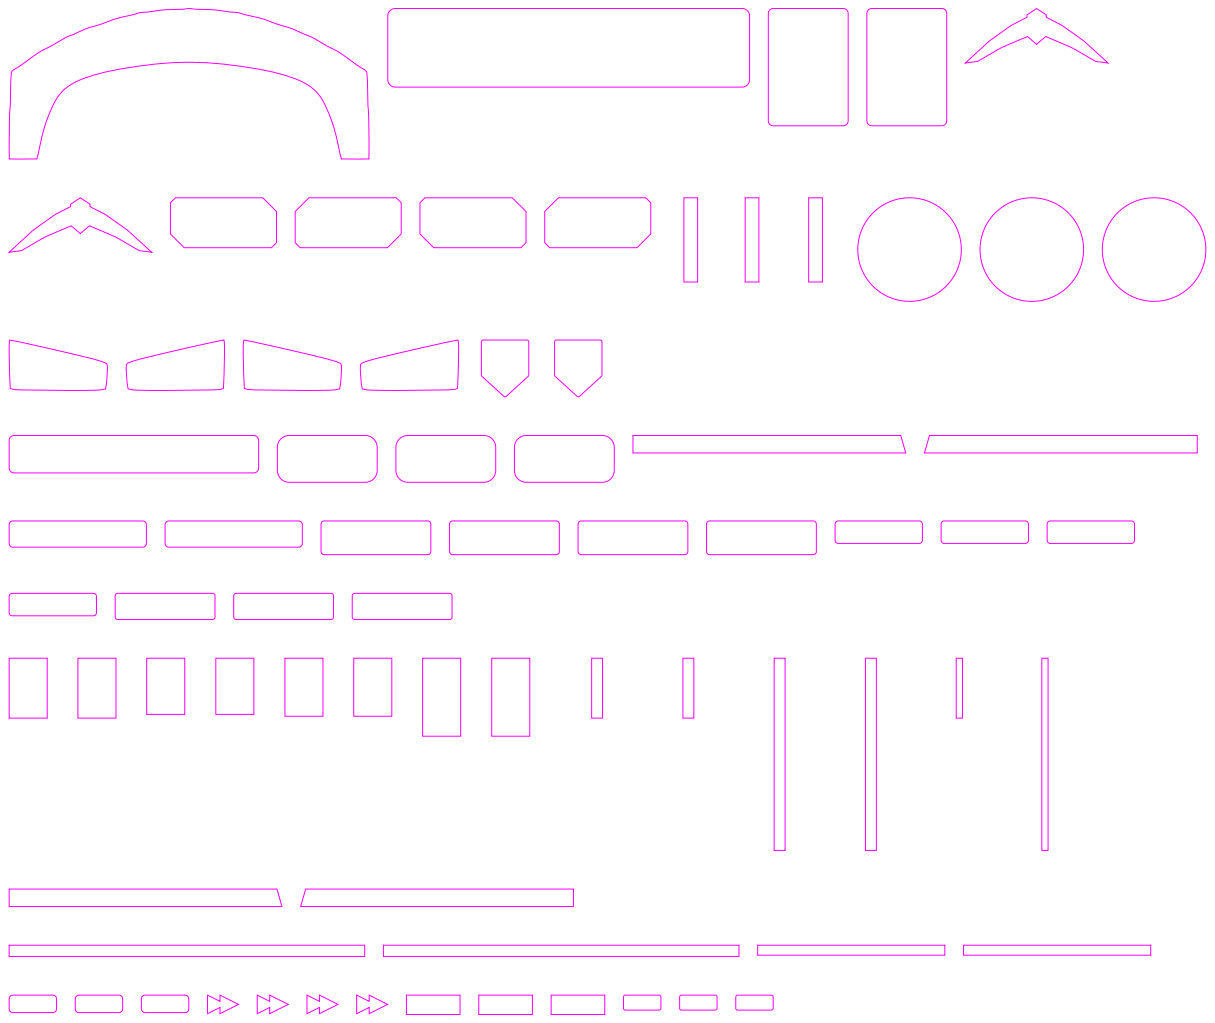
[picture p27: page 1]
