rz7mong/mochi-rzmong/case/stickers_gundam/sticker_sheet_A4_white_vinyl.pdf

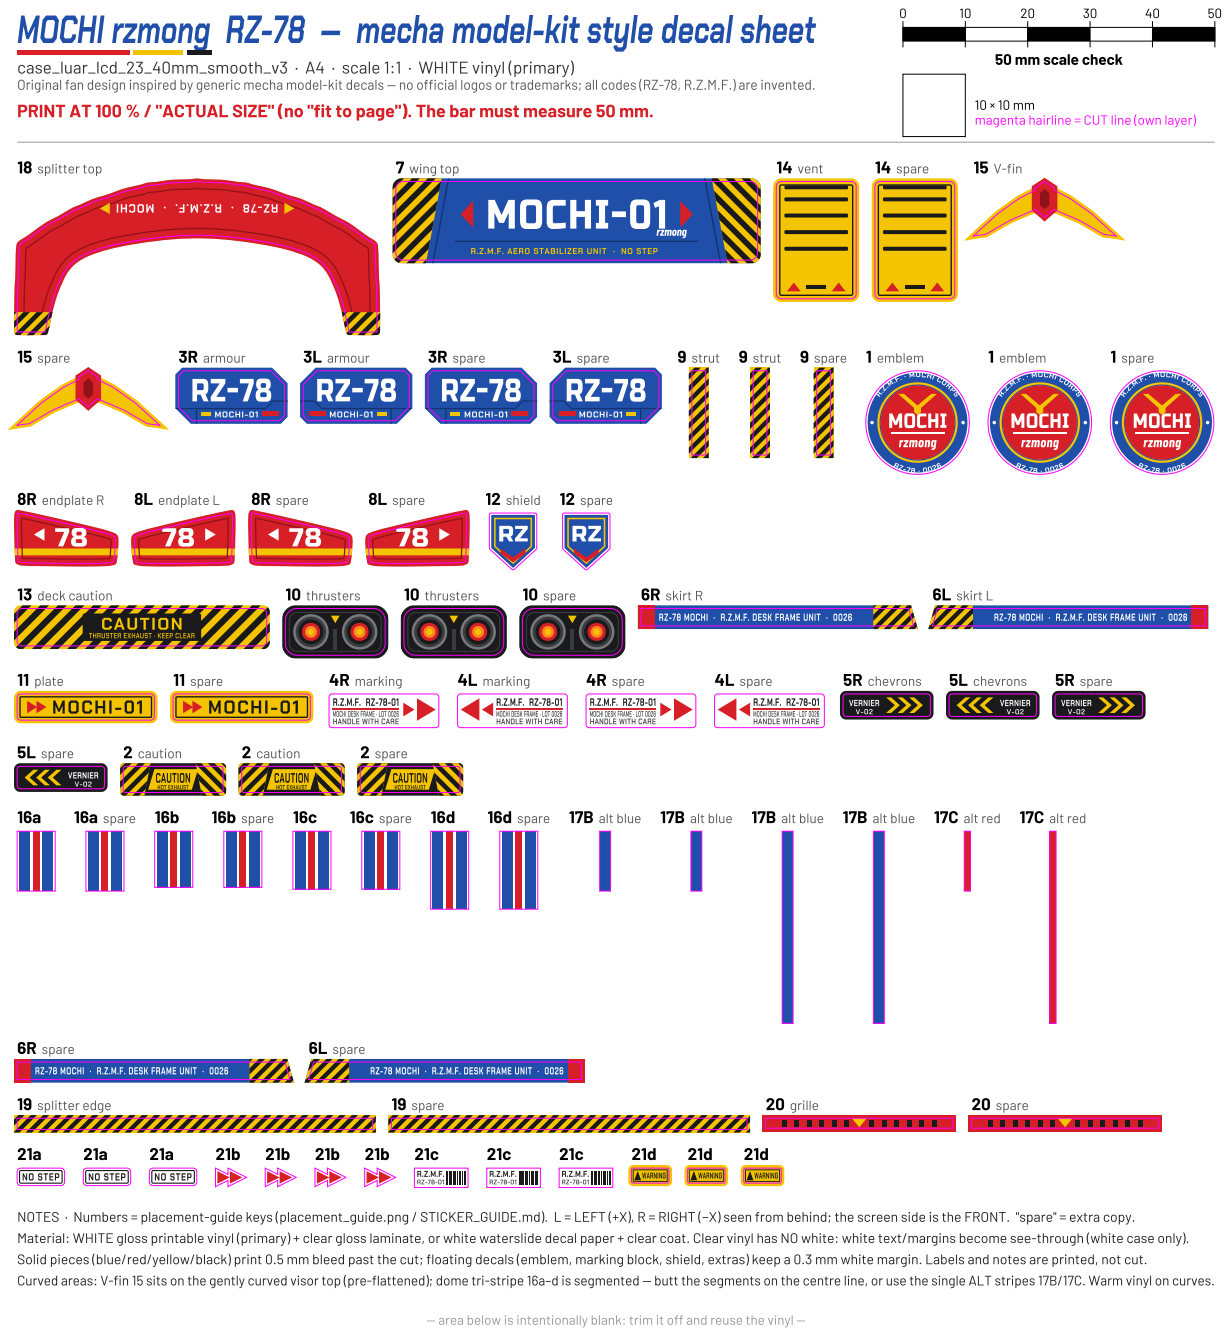
[picture p28: page 1]
