rz7mong/mochi-rzmong/case/stickers/sticker_sheet_A4_clear_vinyl.pdf

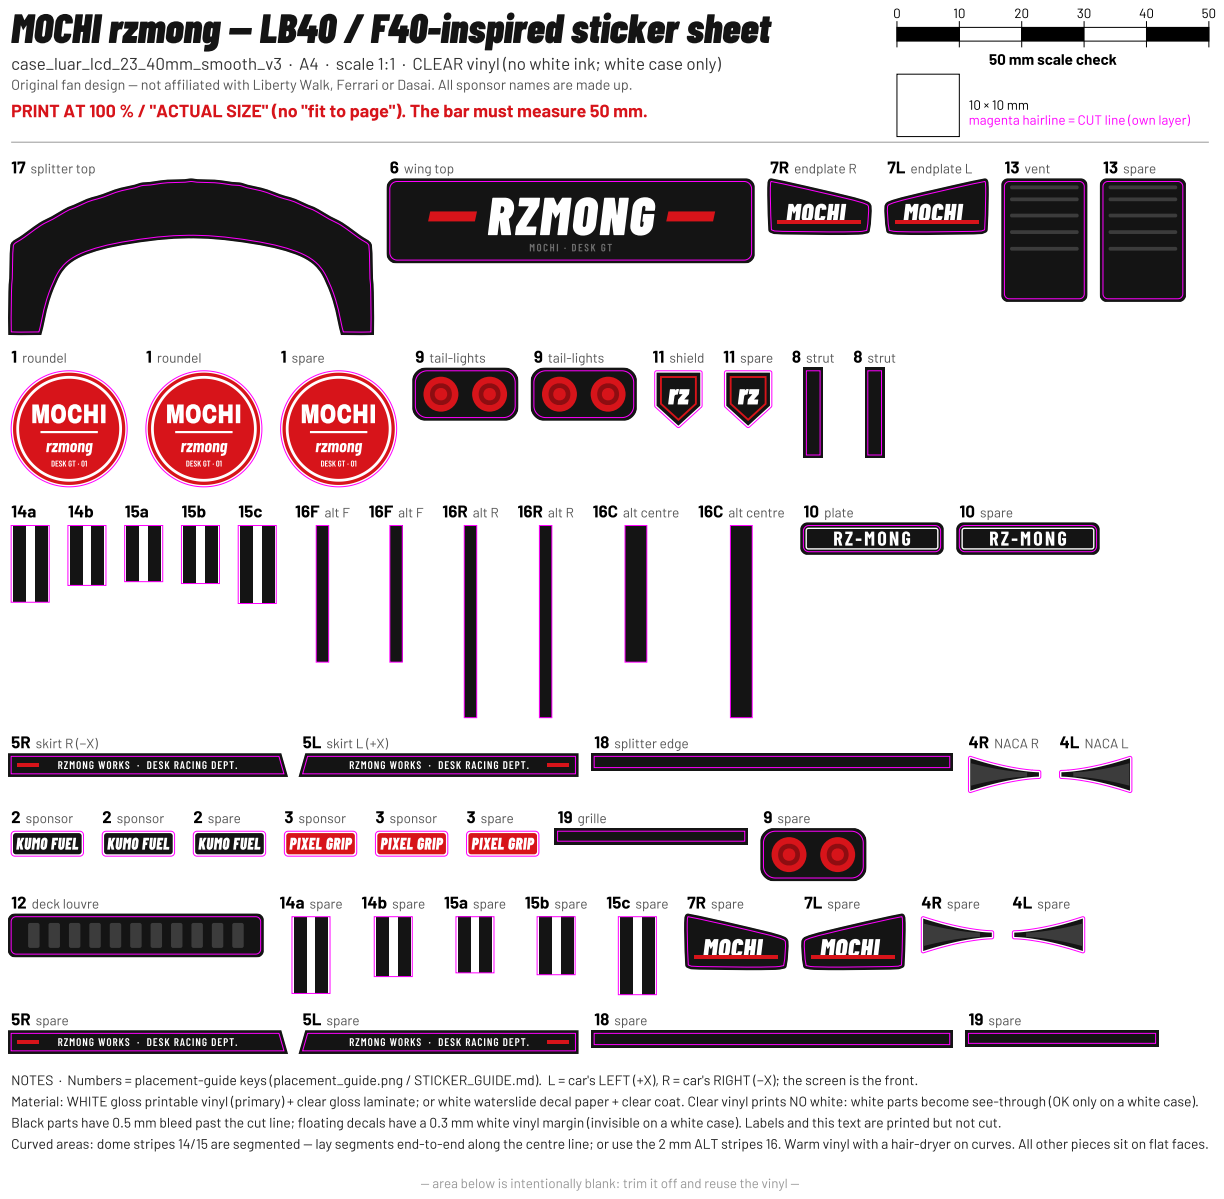
[picture p29: page 1]
