rz7mong/mochi-rzmong/case/stickers/sticker_sheet_A4_CUT_ONLY.pdf

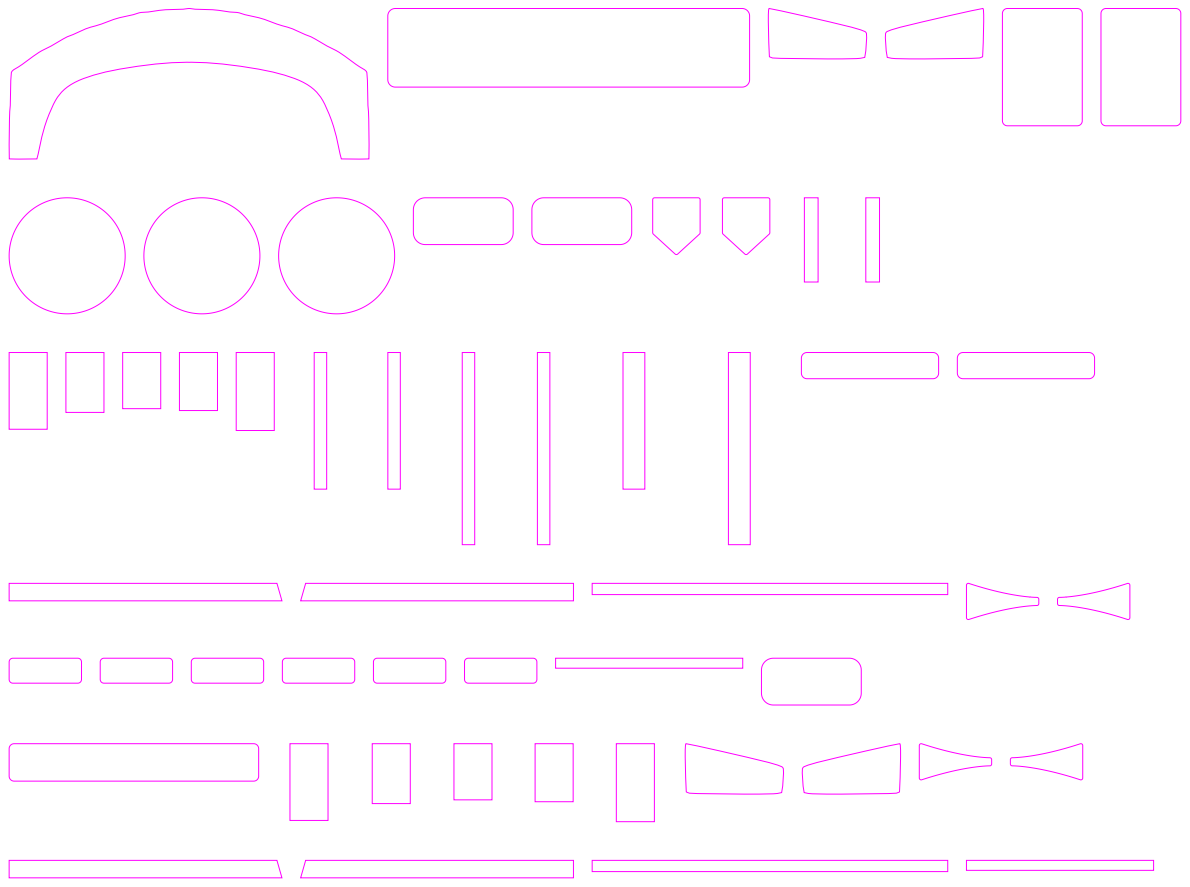
[picture p30: page 1]
