rz7mong/mochi-rzmong/case/stickers/sticker_sheet_A4_white_vinyl.pdf

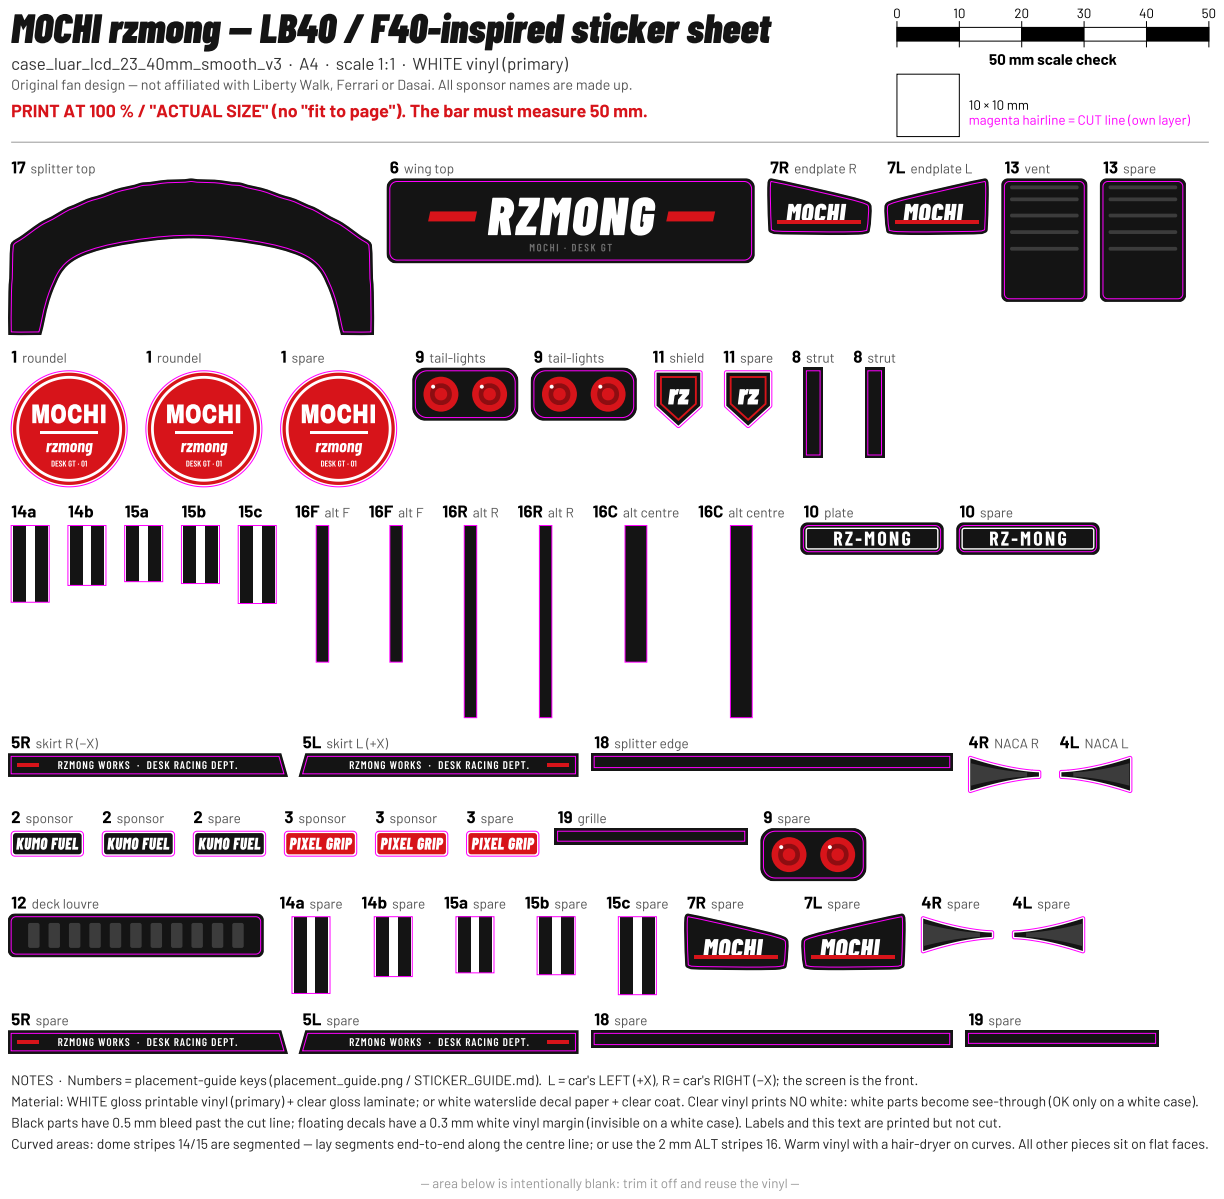
[picture p31: page 1]
