rz7mong/mochi-rzmong/(list of files, drawings)

Other design files:
case/scripts/pcb_fit/pcb_assembly_region.json
case/scripts/pcb_fit/pcb_recommended_outline.json
pcb/outline/pcb_recommended_outline_v2.json
