rz7mong/mochi-rzmong/(commit log)

2026-09-29 fix: hapus paket audio yang tidak ada supaya firmware.bin bisa di-compile
2026-09-29 ui: hapus teks yang dilingkari, ganti judul jadi Instalasi ESP32 by rzmong
2026-09-29 docs: jelaskan cara jalan di menu LCD (bukan geser)
2026-09-29 docs: halaman merakit hardware, BOM, diagram pin, tautan case STL
2026-09-29 docs: hapus Nạp, Huykhong, Dasai clone, kata Watermark dari README dan library
2026-09-29 docs: rapikan teks unduhan case STL
2026-09-29 docs: README case tanpa teks chat
2026-09-29 feat: GIF bawaan flash, jingle tes, SPI SD GPIO2, partisi 4MB
    [partitions.csv]
2026-09-29 feat: GIF flash default, jingle I2S, SPI MISO GPIO2
2026-09-30 fix: header pustaka utuh di firmware
2026-09-30 feat: reaksi sentuh dari flash ESP32 (PROGMEM)
2026-09-30 optimize hardware: saklar + MAX98357 from battery + emojis
2026-09-30 README: emojis + power path update (saklar + amp from battery)
2026-09-30 HANDOFF: version 0.2.2 + power notes
2026-09-30 pins: avoid strap GPIO2/9 — MISO=3 RST=0 DIN=8
2026-09-30 TFT RST GPIO8→GPIO0 (boot-safe)
2026-09-30 hardware: pin map boot-safe v0.2.3 + strap notes
2026-09-30 README: pin map v0.2.3 boot-safe
2026-09-30 HANDOFF: pin map v0.2.3
2026-09-30 panduan: pin v0.2.3 troubleshooting
2026-09-30 docs: fix consistency — WAV only, GIF only, 900ms, menu, build deps
2026-09-30 feat: pilih tema default di web (9 tema + polisi), sinkron API ESP32
2026-09-30 feat: tambah opsi tema polisi di Studio
2026-09-30 docs: jelaskan tema default web + ganti manual di ESP32 (v0.2.5)
2026-09-30 feat(v0.2.6): theme default from web + manual select on ESP32 LCD when SD present
2026-09-30 feat(web): dual theme select — web default + LCD manual when SD (v0.2.6)
2026-09-30 chore(v0.2.6): sync docs, embed_assets, CI — dual theme + rebuild ready
2026-09-30 docs: address review — MIT, EN summary, pin tables, Wi-Fi note, CHANGELOG, no overclaim
2026-09-30 docs: hardware pin tables + panduan troubleshooting v0.2.6
2026-09-30 fix(docs): honest pin notes (GPIO8 strap, UART0), rename pengaturan.html, Keterbatasan
2026-09-30 feat(fw 0.2.7): softAP password from device MAC (rz+last4hex)
2026-09-30 docs: THIRD_PARTY_NOTICES, assets license, SPI/power notes, README.en, pin wording
2026-09-30 docs: README ID primary + README.en.md; pin/power/SPI clarity; CI badge
2026-09-30 feat(fw 0.2.9): sdBusy SPI guard; version bump; hardware power note
2026-09-30 feat(fw): sdBusy guard for shared TFT/SD SPI bus
2026-09-30 feat(0.3.0): captive settings at http://192.168.4.1/; pin platform; docs sync
    [partitions.csv]
2026-09-30 feat: v0.4.0 — Studio convert (FFmpeg.wasm) + POST /api/upload ke SD
2026-09-30 feat(studio): convert MP4/MP3 in browser + upload to ESP32 SD (v0.4.0)
2026-09-30 docs: v0.4.0 README, instalasi, panduan — Studio upload
2026-09-30 feat(studio): convert → preview → Simpan ke perangkat atau Upload ke Mochi (v0.4.1)
2026-09-30 feat(studio): auto-extract audio from video so GIF+WAV are paired for ESP32
2026-09-30 fix(firmware): captive portal DNS + OS probe routes (v0.4.8)
2026-09-30 fix(firmware): DNS captive portal + probe routes + CORS on API
    [main.cpp]
2026-09-30 fix(firmware): restore main.cpp + captive DNS portal (v0.4.8)
    [main.cpp]
2026-09-30 fix(firmware): restore complete main.cpp (was truncated)
    [main.cpp]
2026-09-30 feat(firmware): Chronos full support for ESP32-C3 (v0.4.9) — payload chunks
2026-09-30 fix(firmware): v0.5.1 serviceNet, CORS, touch, no ap_pass
    [main.cpp]
2026-09-30 ci: import official 23x40mm case STL
2026-09-30 ci: simplify import-stl workflow
2026-09-30 add: official case STL 23x40mm
    [case_luar_lcd_23_40mm.stl, tatakan_lcd_23_40mm.stl]
2026-09-30 docs: tautan unduh STL case 23x40mm + hapus workflow import
2026-09-30 docs: tautan unduh STL di blueprint
2026-09-30 ci: remove spent import-stl workflow
2026-09-30 docs: rapikan README, lisensi MIT, About, HANDOFF, pin caveat
2026-09-30 docs: Dasai terinspirasi + peringatan pin UART/strapping
2026-09-30 ci: import wiring diagram 0.5.1
2026-09-30 docs: wiring diagram firmware 0.5.1
2026-09-30 docs: embed wiring diagram 0.5.1
2026-09-30 docs: tampilkan diagram wiring di blueprint
2026-09-30 ci: refresh wiring diagram presisi
2026-09-30 docs: wiring diagram presisi 0.5.1 (titik GABUNG)
2026-09-30 docs: kapasitor MAX98357, SD native 3.3V, wiring README = hardware 0.5.1
2026-09-30 docs: SD native 3.3V + kapasitor 470uF di VIN MAX98357
2026-10-01 docs: pasang wiring diagram 0.5.1 resmi
    Ganti docs/wiring-0.5.1.jpg dengan diagram yang cocok pin firmware,
    tampilkan di hardware.html, dan hentikan impor catbox yang bisa menimpa.
2026-10-01 fix: firmware 0.5.2 GIF, Chronos preempt, SFX RAM, Pages redeploy
    Sync installer and headers to 0.5.2. AP name and password unchanged.
    [main.cpp]
2026-10-01 sync: align site and docs with firmware 0.5.2
    Pin library versions, drop unused patch/test files, and stop blocking BLE on find-my-watch.
2026-10-01 feat: clock face from Chronos phone time
    Menu Jam HP shows the phone time. Notifications, calls, and nav still preempt it.
    [main.cpp]
2026-10-01 fix: clock eyes sit below time and blink with a lid
    [main.cpp]
2026-10-01 Smooth case dome and add locking lips to tatakan for resin printing
2026-10-01 fix: keep clock time visible over idle GIF and sync docs
    [main.cpp]
2026-10-01 docs: update case STL sizes and resin notes
2026-10-01 Add LBWK-style sticker sheet for case
2026-10-01 Add Gundam-style sticker sheet for case
2026-10-01 Translate sticker READMEs to Indonesian and fix case file name
2026-10-01 Add Yae Miko-inspired sticker sheet for case
2026-10-01 Fit LCD GMT130: tatakan baru, docs 27.78x39.22 mm 7-pin, rotasi default 2 (v0.5.4)
2026-10-01 PCB carrier v3 + varian case/tatakan _pcb, laporan fit, docs BOM (v0.5.4)
    - pcb/: PCB etsa tangan satu sisi 38.5x36 mm (FR4 1.6 mm, THT): artwork
    tembaga 1:1 (PDF/SVG), sumber layout v3 (Python), cek net/DRC, catatan rakit,
    outline v2 (DXF/SVG/JSON), README.
    - case/: case_luar_lcd_23_40mm_pcb.stl (grille speaker, slot saklar, pad
    tumpuan) + tatakan_GMT130_fit_pcb.stl (2 tiang M2). STL asli tidak diubah.
    - case/scripts/pcb_fit/: skrip fit/penempatan/cek, path relatif repo.
    - docs/fit/: REPORT.md, review layout v3, pratinjau, placement v7 terverifikasi.
    - README, README.en, case/README, hardware.html, CHANGELOG: varian PCB
    (speaker 15x11x3.5, elko 470uF 6.3x11, modul SD 3.3V ~18.5x20,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
    [pcb_assembly_region.json, pcb_recommended_outline.json, pcb_recommended_outline_v2.dxf, pcb_recommended_outline_v2.json]
2026-10-01 fix: firmware 0.5.5 — jam HP, SPI, upload SD, versi selaras
    Jam HP memakai GIF wajah/default yang tertanam. SPI bersama di-init sebelum TFT.
    Upload menutup pemutar yang memegang SD. Portal, installer, dan dokumen ikut 0.5.5.
    [main.cpp]
2026-10-01 docs: emoji di README, halaman, dan portal captive
    Judul bagian memakai emoji supaya repo dan pengaturan di HP lebih mudah dipindai. Teks LCD tidak diubah.
2026-10-01 docs: demo cara pemasangan interaktif (versi PCB + kabel lepas)
2026-10-01 Restyle HTML pages to match PCB install page design
2026-10-01 firmware 0.5.6: 30 built-in GIF+WAV slots (new smile+blink default), built-in sound from flash, 11 tap reacts
    - firmware/assets/builtin/: 30 GIF (782,448 B) + 8 kHz mono WAV (259,200 B PCM); order in assets/meta.json builtins
    - embed_assets.py rewritten: reads meta.json, embeds PCM per slot, fails on missing GIF (no more stand-ins; fixes jam-hp/default bug)
    - main.cpp: built-in WAV played from flash, react sound SD > built-in > jingle, idle flash WAV (default.wav only once after boot),
    theme+stem lookup, phone clock honours GIF frame delay, wajah/default between idle clips
    - MOCHI_REACT: tickle raspberry, kedip squint, cinta love_hearts_kiss, marah angry_2, ketawa smirk, ngantuk sleepy,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
    [main.cpp]
